Brigchen/iAquaria/iAqua/test/微信图片_20260914183111_5_65.jpg

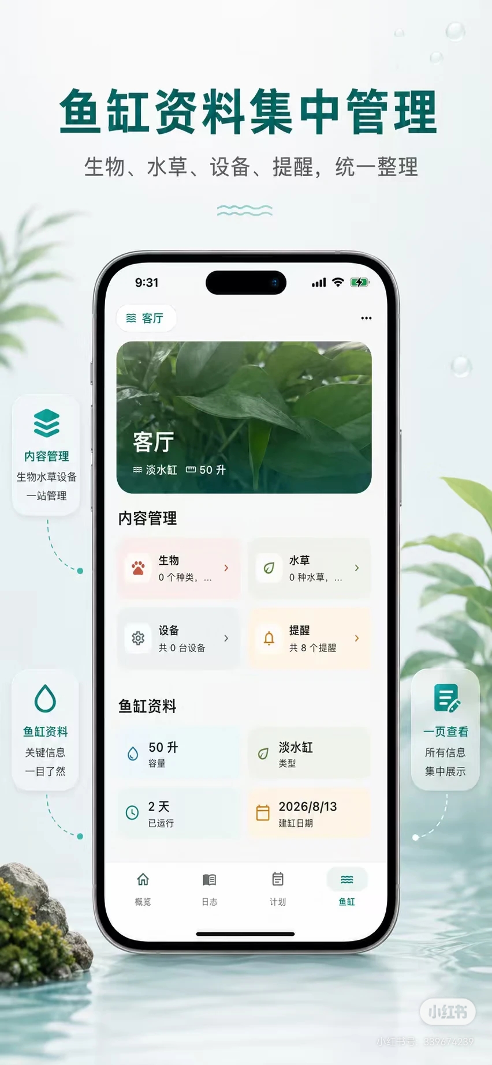
iAqua/test/微信图片_20260914183111_5_65.jpg
