Brigchen/iAquaria/iAqua/test/微信图片_20260914183106_3_65.jpg

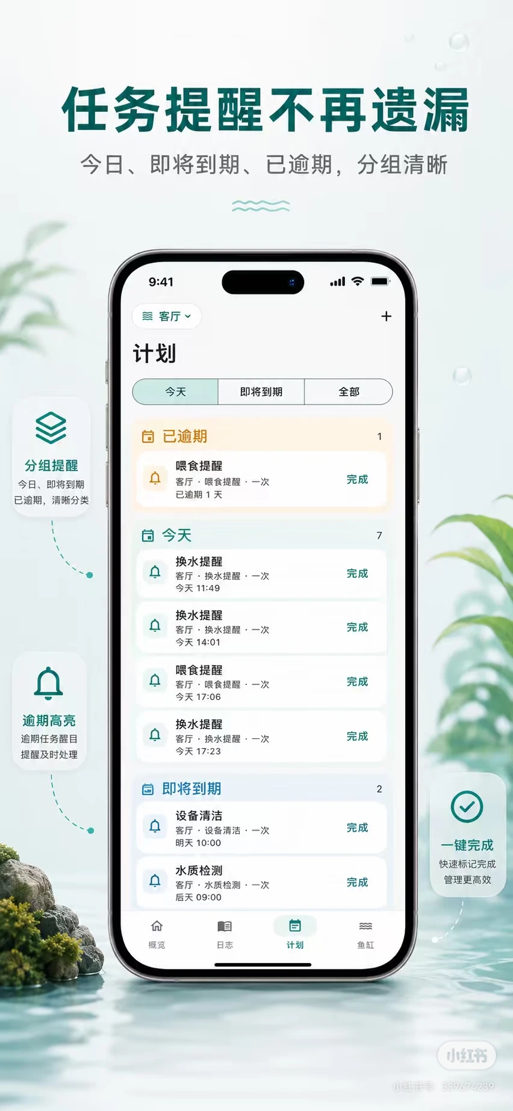
iAqua/test/微信图片_20260914183106_3_65.jpg
