Brigchen/iAquaria/docs/cam_hanger/README.md

# 鱼缸外挂摄像头吊架

A 板三颗 **Ø8.1** 孔（最上顶玻璃，下面两孔锁 B）；B 板长槽调长度。垫板中心同样 Ø8.1。两块均为封闭可打印实体。螺丝缩短，不进入玻璃。

重建：`build_cam_hanger.py`（需场景中已有 `Wall-mount`、`ball standard`、`Finger Screw`）。打印件：`CamHanger_Upper.stl`、`CamHanger_Lower.stl`。
