Brigchen/iAquaria/docs/gy30_case/README.md

# GY-30 光照外壳

PCB **32.6×15.1 mm**，焊针后总高 **11.2 mm**。BH1750 中心距顶边 **12 mm**。感光面朝上。

上壳套在下壳外面。左右长边有互配波浪纹卡住。上盖顶厚 0.75 mm。底板两端是以固定孔为圆心的半圆。走线在**短边**，用上下开口槽而不是封闭圆孔：先装板、放线，上盖仍能套下去。下壳左右内壁各 1 mm 托板、高 8 mm。STL：`GY30_Base.stl`、`GY30_Lid.stl`。
