Brigchen/iAquaria/docs/sr04_bracket/README.md

# HC-SR04 缸沿支架

**倒 L + H 夹**：上横板（**34**×80，四角倒圆 Ø10，2×M3，孔心距内竖板 15 mm）托 **12 mm** 厚超声波，传感器在**横板下面**。H 内外竖板与横档均为 **5 mm 厚、50 mm 宽**；内竖板一通到横板底，顶部开 **23×12 mm** 过线口。外侧 **2×M8×1.25 内螺纹**（大径 8.5）顶紧（≤10 mm 玻璃）。

尺寸见 [dimensions.md](dimensions.md)。重建：`build_sr04_bracket.py`。打印件：`stl/SR04_Bracket.stl`。
