Brigchen/iAquaria/docs/tds_h_bracket/README.md

# 单 TDS 缸沿支架

用于单独测 TDS：H 夹骑缸沿，上横板高出 20 mm，缸内竖板下伸 **140 mm**，上下各一个 **Ø10** 孔。外竖板 **1×M8×1.25 内螺纹**（大径 8.5）顶紧，横板 **21.8×18 mm**。总高 **170 mm**。游离直角倒成直径 **10 mm** 弧角，两板连接处保持直角。

尺寸见 [dimensions.md](dimensions.md)。重建：`build_tds_h_bracket.py`。打印件：`stl/TdsH_Bracket.stl`。
