Brigchen/iAquaria/docs/cam_hanger/dimensions.md

# 鱼缸外挂摄像头吊架

A = 靠玻璃的外竖板（与挂钩一体），**三颗 M8×1.25 内螺纹**。B = 外侧竖板，长槽调长度。

| 项 | mm |
|---|---|
| 板厚 | **5** |
| 竖板宽 | **18** |
| A / B 各长 | **100** |
| 凹字 | A 板外侧（顶孔与下孔之间）**iAquaria-JMU**，长 **34**，深 **1** |
| 玻璃槽 | **12**（≤10 mm 玻璃） |
| A 最上孔 | **Ø8.1**，顶玻璃 |
| A 下面两孔 | **Ø8.1**，与 B 槽锁相对位置 |
| B | 槽宽 **9.0**、长 80（通孔槽，螺丝穿过再旋入 A） |
| 接头垫 | 30×30×5，中心 **Ø8.1**，游离角倒圆 |
| 倒角 | 竖板游离端沿板面 **Ø10**；垫板游离角 **Ø10**。上横板与竖板相连处不倒。 |
| A/B 螺丝 | M8×1.25，牙长 **10**（头在 B 外侧，不进入玻璃槽） |
| 顶玻璃螺丝 | M8×1.25，牙长 **8** |

打印件：`CamHanger_Upper.stl`（A）、`CamHanger_Lower.stl`（B）、`M8x1.25x20.stl`。

四孔（A 竖向三孔 + 垫板中心）均为封闭实体上的 **Ø8.1** 孔（比 M8 大径 8.0 略大，PETG 自攻能咬住）。B 槽仍为 Ø9 以便穿过。A/B 各为一块封闭网格。
