Brigchen/iAquaria/docs/probe_h_bracket/dimensions.md

# 温度 / TDS / pH 缸沿支架（倒 L + 整体 H 夹）

坐标系：玻璃演示 X=0..8，**缸沿顶面 Z=0**；缸内 −X。上横板底面 Z=**20**（缸沿上 2 cm）；下横板顶面 Z=**−140**（缸内下伸 14 cm）。总高 **170 mm**（上顶到下底）。

横板伸入缸内按 **Ø30** 收到最窄；沿缸沿随孔径加宽，四孔：水温、TDS、pH、pH 补偿温度（贴 pH）。

H 夹：槽宽 12（≤10 mm 玻璃），外侧 **2×M8**。

## 上 / 下横板（同孔径）

| 项 | 尺寸 mm |
|---|---|
| 外廓 | **41.8 × 70.8 × 5**，游离端两角倒圆 **Ø10**（R5；靠竖板的角不倒） |
| 上横板 | 底面 Z=**20** |
| 下横板 | 顶面 Z=**−140** |
| 水温孔 | **Ø8.2**（名义 Ø8），Y = **−28.5** |
| TDS 孔 | **Ø10.2**（名义 Ø10），Y = **−16.5** |
| pH 孔 | **Ø30.2**（名义 Ø30），Y = **+6.5** |
| pH 补偿温度孔 | **Ø8.2**（名义 Ø8），Y = **+28.5**（pH 旁） |
| 孔心 X | **−23.9**（贴竖板，Ø30 + 2.8 壁） |

探头从上横板穿入，由下横板第二孔导向，保持竖直。

## 缸内竖板

| 项 | 尺寸 mm |
|---|---|
| 壁厚 | 6 |
| 宽度 Y | 70.8（与横板同宽） |
| 下伸 | 缸沿向下 **140**，连到下横板 |
| 总高 | **170**（上横板顶 Z=25 → 下横板底 Z=−145） |

## 竖向 H 夹

| 项 | 尺寸 mm |
|---|---|
| 槽宽 | **12**（≤10 mm 玻璃） |
| 外侧壁 | 厚 **6**（与内竖板相同）、宽 **70.8**、下垂 40 |
| 横档 | 厚 8，骑在缸沿 |
| 2×M8 | **M8×1.25 内螺纹**，大径 **8.5**（配 ISO M8 螺丝），Y=±20，Z=−20 |

打印件：`stl/ProbeH_Bracket.stl`。M8 与超声波支架共用。
