Brigchen/iAquaria/docs/seal_ring/dimensions.md

# 密封圈

两只共用：谷底直径 **72**、两边厚 **3**、谷底厚 **2**、顶面二次曲线、底面平整。

| 件 | 内径 | 外径 | 径向宽 | STL |
|---|---|---|---|---|
| A | **68.5** | **75.5** | 3.5 | `stl/SealRing.stl` |
| B | **68.75** | **75.25** | 3.25 | `stl/SealRing_68.75.stl` |

帽形密封件（内腔不变，帽壁向外 **1.6 mm**）：

| 项 | mm |
|---|---|
| 底面椭圆 | **22 × 11** |
| 帽体外 | 长轴 **13.2**，短轴 **8.2**（腔内 + 2×1.6） |
| 底孔 | **8 × 4**（不变） |
| 腔内 | **10 × 5**（不变） |
| 帽壁 | 长/短轴均为 **1.6** |
| 总高 | **5.4**（顶壁 1.6，腔内顶 z 不变） |
| 边沿厚 | **1** |

打印件：`stl/SealCap.stl`。
