Brigchen/iAquaria/docs/sensor_mounts/dimensions.md

# iAqua 传感器支架 — 严格尺寸（mm）

坐标：穿壁板 **X 右、Z 上**；**Y 穿玻璃**（缸外 Y+，缸内 Y−）。板中心为原点 (0,0,0)，板面在 XZ 平面。

## 1. Bulkhead_Outer / Bulkhead_Inner / DrillGuide

| 项 | 尺寸 |
|---|---|
| 板外廓 | 120 × 100 |
| 外板厚度 | 8.0 |
| 内板厚度 | 6.0 |
| 设计玻璃厚度 | 8.0（6–12 用 M4 垫圈 shims） |

### 1.1 四角 M4 穿板（对夹玻璃）

| 孔位 (X, Z) | 孔径 | 备注 |
|---|---|---|
| (−50, −40) | **Ø4.4** 通孔 | M4 螺栓 clearance |
| (+50, −40) | Ø4.4 | |
| (−50, +40) | Ø4.4 | |
| (+50, +40) | Ø4.4 | |

**外板缸外面**：同位置 **沉孔 Ø8.0 × 深 4.2**（M4 内六角圆柱头 ISO 4762）。

**内板缸内面**：同位置 **M4 六角螺母腔 7.8 对边 × 深 5.0**（通孔仍 Ø4.4）。

**玻璃上钻孔**：Ø4.2（M4 通孔），孔心同上表。

### 1.2 密封槽（外板贴玻璃面、内板贴玻璃面各一圈）

| 项 | 尺寸 |
|---|---|
| 槽中心线 | 距板边 5.0 |
| 槽宽 | 2.0 |
| 槽深 | 1.5 |
| 填料 | Ø2 硅胶条或硅酮胶 |

### 1.3 传感器 / 线缆孔（板与玻璃同轴）

| 名称 | 中心 (X, Z) | 板孔 Ø | **玻璃钻孔 Ø** | 连接件 |
|---|---|---|---|---|
| TEMP DS18B20 | (−30, +8) | 6.4 | **6.0** | `Gland_Body_6mm` + `Gland_Ring_6mm` + 采购 M10×1 锁母 |
| pH 电极 | (0, +8) | 12.5 | **12.0** | 电极自带 M12×1.5 锁母 + Ø12 O 圈 |
| TDS 电极 | (+30, +8) | 12.5 | **12.0** | 同上 |
| PG7 线缆 | (0, −28) | **12.5** | **12.5** | 采购 **PG7** 防水接头（锁板厚 2–8 mm） |

PG7 标准：建议孔 **12.5 mm**；锁紧螺母外径约 18 mm，外板此处无沉孔，靠 PG7 金属螺母压紧。

### 1.4 紧固件清单（单套穿壁板）

| 件 | 规格 | 数量 |
|---|---|---|
| 内六角螺栓 | M4 × 45 不锈钢 | 4 |
| 平垫 | M4 外径 9 | 4 |
| 螺母 | M4 不锈钢 | 4（或用内板 nut trap + 螺栓从外拧入） |
| 玻璃垫 shims | PETG 0.5 / 1 / 2 mm | 按需 |

---

## 2. Gland_6mm（DS18 探头）

| 项 | 尺寸 |
|---|---|
| 法兰外径 | 24.0 |
| 法兰厚 | 8.0 |
| 通孔（探头） | Ø6.4 H7 |
| 外螺纹区 | 模拟 M10×1：外径 10.0，有效长 12.0（实际用 M10 锁母压法兰） |
| `Gland_Ring_6mm` 内孔 | Ø6.0 → 锥面压紧 6 mm 探头 |

---

## 3. RimClip_Base + RimClip_Jaw

| 项 | 尺寸 |
|---|---|
| 夹口高度（可调） | 8.0–12.0（默认 10.5 开口 + 1.5 预压） |
| 夹持深度（扣入缸沿） | 14.0 |
| 轨槽 | 宽 20.0 × 深 6.0 × 长 14.0（`VerticalRail` 榫头） |
| 压紧螺钉 | **M5×50** 内六角 |
| 固定块孔 | Ø5.5 通孔 |
| 活动块 | M5 **六角螺母腔 9.0 对边 × 深 5.0**（缸外可及） |

---

## 4. VerticalRail

| 项 | 尺寸 |
|---|---|
| 外廓 | 20 × 128 × 6 |
| 底部榫头 | 20 × 12 × 6（插入 RimClip 槽） |
| 轨向 M3 安装孔 | Ø2.9 通孔，Z 中心距底 **18, 38, 58, 78, 98, 118** |
| 螺钉沉孔（贴缸壁面） | Ø6.5 × 深 3.2（M3 内六角 ISO 4762） |
| 侧向锁紧 | M4 螺纹孔 **3.2 底孔** + 打印 **M4 热熔铜螺母**，位置 (X=+8, Z=6) |

---

## 5. Mount_SR04（HC-SR04）

| 项 | 尺寸 |
|---|---|
| PCB 包容 | 45.0 × 20.0 × 15.0（Transducer 朝下） |
| 侧夹持 | 内宽 20.2，深 12.0 |
| 安装耳 | 2× Ø2.9，孔距 **20.0**（Z 向），距背板中心线 ±10 |
| 固定螺钉 | M3×10 内六角 × 2 |

---

## 6. Mount_BH1750（GY-30）

| 项 | 尺寸 |
|---|---|
| PCB 包容 | 16.5 × 16.5 × 5.0 |
| 腔体 | 22 × 22 × 12（顶开，线从背板 PG7 或走线孔 Ø4.0） |
| 倾角 | 15°（受光面朝灯带） |
| 安装 | 2× Ø2.9，孔距 20.0，M3×8 |

---

## 7. 装配顺序（穿壁）

1. `DrillGuide` 贴玻璃标记 → 钻 4×Ø4.2 + 1×Ø6 + 2×Ø12 + 1×Ø12.5。  
2. 玻璃两面清洁，贴密封槽硅胶。  
3. 内板（湿）→ 玻璃 → 外板（干），M4×45 对角拧紧 **2 N·m** 量级，勿爆玻璃。  
4. 探头 / PG7 从缸内穿出，锁母 + O 圈。  
5. DS18 先穿 `Gland_Ring` + 法兰，再锁 M10 螺母。
