Brigchen/iAquaria/docs/演示文稿1.pptx

6mm

12mm

22mm

11mm

1mm

7mm

12mm

22mm

10mm

5mm

缸外

缸内

上横

调节壁厚固定螺丝

A竖板

夹玻璃

固定AB竖板螺丝

B竖板

万向接头

下面接摄像头

## Slide 2

阿卡
（在相机顶面，上宽下窄，才可以卡坐快接母口）

镜头
（前视角）

USB-type-c 母座模块
（在相机底面）
