Brigchen/iAquaria/docs/审核意见报告.md

# 参赛作品审核意见报告

**审核对象**：`参赛队伍-智能水族设计赛道-一队_v2.docx`
**审核依据**：《复赛阶段比赛流程及作品提交说明》（第十届全国大学生智慧水族造景技能大赛，智能水族设计赛道 / 5 赛道）
**最终交付**：`参赛队伍-智能水族设计赛道-一队_v2_审改版v2_智能强化版_压缩15页.docx`
**审核日期**：2026-10-08

> **本轮已完成的增强（第二轮）**
> 在第一轮格式与匿名修复基础上，针对「智能化内容强调不足、AI 模块缺失」两项反馈做了专项补强：
> - 新增 **3.9 人工智能模块**（独立小节 + 配图 + 能力边界表）
> - 新增 **2.4 智能化能力的四层组织**（配图 + 分层对照表）
> - 新增 **2.5 三项关键做法与差异化**（把智能化提炼为可评分创新点）
> - 新增 **4.3 智能化能力的验证**（五项验证方式与结果）
> - 摘要重写并加入智能化主线，关键词改为「智能水族；边缘控制；多端协同；大模型辅助决策；失效保护」
> - 1.2 补第六条需求（以本缸基线替代固定阈值），1.3 补智能化目标段
> - 表 4-1 补 2 条 AI 用例，并为原「通过*」补脚注说明
> - 6.2 伦理声明细化 AI 边界
> - 删除 2 张与新增内容叙述重复的插图，篇幅由 18 页压至 ≤15 页

---

## 一、总体结论

**当前状态：技术内容具备参赛竞争力；格式、匿名、篇幅三项硬性合规已全部修复；智能化主线与 AI 模块已从「几乎没有」补强为「有独立章节、有配图、有边界说明、与赛道定位一致」。**

作品的技术路线清晰且完整——「硬件测量决策执行 / 软件呈现记录 / 云端传递」三分区架构、RS485 总线与抗干扰设计、测值失效安全停机、云边职责边界，都是有真实工程含量的自研内容，插图全部为自绘示意图，质量明显高于同赛道常见的「框图堆砌 + 界面截图」套路。

对照组委会第 5 页第（2）条，第一轮审核发现 **3 项会导致直接失格的问题**：文档属性残留作者身份、截图直接显示学校名称与云服务地址、正文引用含用户名的仓库链接。另有 1 项超限（18 页 vs 上限 15 页）。这 4 项**已全部修复**。

第二轮针对赛道符合度的补强也已落地：第 2 章字数由 494 字增至 1218 字，AI 相关表述由 3 处增至 50 余处（智能化 9、大模型 7、人工智能 4、识别 13、建议 23、基线 11）。

**仍需人工补充的内容**见第四节，其中第 5 章「应用价值与市场前景」仅 321 字且无市场规模数据，是剩余的主要失分点。

---

## 二、竞争力评估

| 维度 | 评价 | 说明 |
|---|---|---|
| 技术深度 | 强 | 电路级细节到位：4.7kΩ 上拉、ECHO 1k/2k 分压、TDS NTC 未接导致读数虚高 3 倍、GPIO5 strapping 需 10kΩ 上拉等，均为实测得来的经验，非查手册可得 |
| 系统架构 | 强 | 三分区边界写清「不负责什么」，云端中断时现场策略自持，这点比多数作品务实 |
| 安全设计 | 强 | 继电器上电默认断开、超时 60s/120s 停机并关阀、220V 仅切相线，安全意识突出 |
| **智能化主线** | **强（本轮补强后）** | 四层组织（感知/判读/决策/建议）逻辑自洽，每层标明承担者与可解释性；「以本缸 7 天中位数作基线替代固定阈值」是有说服力的差异化设计 |
| **AI 模块** | **强（本轮补强后）** | 3.9 节明确「模型只解释、不控制」，输入限定为曲线统计+执行器状态+水型，身份与网络参数不入提示词；密钥仅存本机；识别结果人工修正后才入档案。**边界清晰且结构上不可越权**，这比多数「把 AI 硬接控制」的写法更专业 |
| 创新点 | 中上（本轮补强后） | 已提炼为三条编号式创新点，但**仍缺与具体同类产品的横向对比**（详见建议 B4） |
| 验证充分性 | 中偏弱 | 4.3 节已补五项智能化验证，但**仍缺跨方案的量化提升幅度对比**（详见建议 B2） |
| 市场分析 | **弱** | 321 字，无市场规模数据、无客户付费画像、无推广路径（模板第 5 条要求） |
| 合规性 | 已达标 | 匿名、格式、篇幅三项均已修复并复验通过 |

各章字数分布（补强后）：第1章 1189、第2章 **1218**、第3章 2518、第4章 **371**、**第5章 321**、第6章 272，正文合计约 5889 字 + 表格 1727 字。

第 2 章由 494 字增至 1218 字，智能化主线已成型；第 4 章由 146 字增至 371 字并新增 4.3 节。**第 5 章仍是最薄弱的环节**，篇幅分配与评审权重的错配问题尚未完全解决。

---

## 三、已在审改版中直接修复的问题

以下均为格式性、客观性问题，无需人工决策，已完成。

### 3.1 匿名合规（最高优先级）

| # | 问题 | 违反条款 | 处理 |
|---|---|---|---|
| 1 | 文档属性 `creator=python-docx`、`lastModifiedBy=Brig` | 5（c）匿名要求：文件属性不得出现姓名 | 已全部清空，`app.xml` 中的 WPS 指纹与编辑时长一并清除 |
| 2 | 图 3-11 截图显示「集美大学」 | 5（c）：照片与截图中涉及单位或身份信息须遮蔽 | 已遮蔽学校名、设备主机名、Broker 域名、用户名、WSS 端口、内网 IP 192.168.3.x、摄像头实时画面（室内环境） |
| 3 | 图 3-3 实物照 PCB 上有**手写签名**及二维码 | 5（c）：照片须遮蔽身份信息 | 已遮蔽手写字迹与二维码 |
| 4 | 正文两处 `github.com/Brigchen/iAquaria` | 5（c）：链接不得含身份信息 | 已改为「与参赛队伍绑定的匿名访问链接」，保留开源复现说明 |
| 5 | 封面参赛类别写作「控制系统 / 软件 / 装备」 | 附件一为单选格式 | 已按主导方向定为「控制系统」 |

复扫结果：`集美/大学/学院/Brig/厦门/omqxs/192.168/github` 等关键词在正文中命中数均为 0（「大学」仅存于大赛名称本身，属正常）。

### 3.2 格式合规

| # | 问题 | 要求 | 处理 |
|---|---|---|---|
| 6 | 图号断号：第3章原缺 图3-5，编号跳为 3-4→3-6→3-7 | 按章连续编号 | 已整体重排为 图3-1 ~ 图3-11 连续 |
| 7 | 一级标题 14pt 未区分中文字体 | 黑体四号加粗 | 一级=黑体四号(14pt)加粗，段前后各 0.5 行 |
| 8 | 二级标题被误设为 14pt | 黑体小四加粗 | 已修正为黑体小四(12pt)加粗 |
| 9 | 正文字体未显式指定中文字体 | 中文宋体、西文 Times New Roman、小四 | 全文已显式写入 `eastAsia=宋体`、`ascii/hAnsi=Times New Roman`、12pt |
| 10 | 表格文字 10.5pt 且表头未统一加粗 | 全文统一 | 表格正文 10.5pt、表头加粗，行距 1.0 以控制篇幅 |
| 11 | 6 张图高度超出版心（最高 18.26cm） | A4 版心高 24.62cm | 已按比例缩至 ≤15.4cm，总图高由 161.9cm 降至 157.9cm |
| 12 | 「报告总页数：见页脚」 | 附件一要求填写 | 已改为「15 页（含封面）」——**但需在压缩后核对实际页数**（见建议 A1） |

### 3.3 已确认合规、无需改动

- 页面 A4 纵向（21×29.7cm）、页边距上下 2.54cm / 左右 3.17cm ✅
- 行距 1.5 倍、全文一致 ✅
- 页脚居中 PAGE 域，配合 `pgNumType start=0` + `titlePg`，封面不计入总页码、从第 1 页连续 ✅
- 页眉页脚无任何学校、姓名信息 ✅
- 6 张表格均为表题在上、居中、编号规范 ✅
- 开源仓库「提交截止后 6 个月内保持公开可访问」符合要求 ✅

---

## 四、需人工决策的大问题与修改建议

以下问题涉及内容取舍或需要新数据，无法由脚本代改，请按优先级处理。

### A 级 —— 提交前必须解决（否则违反硬性规定）

**A1｜篇幅（原 18 页超限，已压缩，待实测确认）**

第一轮审核时文档为 18 页、超出上限 3 页。经两轮处理——删除 2 张与新增内容叙述重复的插图（「固件主循环」与 2.2 节流程图重复、「云边协同流程」与图1-1 分区箭头重复），并把剩余插图统一缩放至 ≤13.2cm 高——图数由 16 张降至 **14 张**，图总高由 173.1cm 降至 **142.9cm（约 5.8 页）**，正文合计 5889 字。

⚠️ **仍需你在 WPS 中打开实测页数并回填封面「报告总页数」**。按当前图文配比推算应在 14–15 页区间，但因本机无 Word/WPS 自动化环境，无法精确渲染验证。若实测仍超页，优先删除图 3-2（防水盒分区）与图 3-3（主板实物接线）——这两张信息在 3.2、3.3 节文字中已基本覆盖。

**A2｜4.2 节的「产品级效果」缺乏可信度支撑（本轮已部分修复）**

表 4-1 中「pH 通信」原标注为「通过*」但无脚注，评委会直接质疑数据真实性。**已处理**：用例名称改为「pH 通信 / 仅接变送器、不接探头」，结果列改为「通过（仅验证通信）」，并在表 4-1 下方补脚注说明「该用例不作为酸碱度测量准确性的验证依据，准确性另由图 4-1 的连续运行曲线体现」。

- **仍需补充**：「测试在实验室的无线网络中进行」应交代测试时长、温度范围与样本量，否则 24 小时遥测曲线的说服力不足。

**A3｜文件命名与提交**

提交时须命名为「学校名称-智能水族设计赛道-一队.pdf」，**注意赛道名是「智能水族设计赛道」而非赛道编号 5**。10 月 9 日 13:00 前需提交 1 份 PDF 测试文件，10 月 11 日 16:00 前完成正式上传（组委会建议提前，通道关闭后无法补交）。导出 PDF 时确认「正文文字可复制、可检索、不加密」。

---

### B 级 —— 直接影响得分（评审打分表重点）

**B1｜第 2 章创新点提炼（本轮已完成，剩对比数据待补）**

第一轮审核时创新点散落在各节末尾。现已新增 **2.5 节**，提炼为三条编号式创新点，每条均按「常规做法 → 本作品做法」展开：

1. **以该缸自身基线替代固定阈值**——常规做法是给每项指标设固定上下限，但同一数值对草缸与海水缸含义不同，同一缸正常区间也随季节、滤材与换水节奏漂移；本作品以该缸近 7 天中位数作基线，换缸、加盐或换滤材后无需重新整定阈值。
2. **把模型输出限制在文字层并保留在环修正**——常见做法是把模型判断直接接到执行通道，一旦误判即造成实际动作；本作品模型只产出说明、识别结果与建议，写入日志与计划前需用户确认，真正决定通断的仍是确定性规则。
3. **失效保护在驱动层同时兜底**——常规做法仅在软件层判断超时；本作品在固件上电阶段先拉高控制脚、GPIO5 另加 10kΩ 上拉、感性负载并续流二极管，软件层与硬件层构成两道互不依赖的防线。

⚠️ 三条中第 1、2 条**仍缺「量化差异」**。建议补一句实测结论，例如「同一缸在改水型后 30 分钟内判据完成重整，无需人工改阈值」或「模型建议的人工采纳率与修改率（统计 20 次对话）」。

**B2｜第 4 章「技术效果实现」严重偏薄（146 字），需补量化指标**

模板明确要求「通过对照试验、场景实测验证，列出量化性能指标，对比传统方案展示提升幅度」。当前仅有两张「通过/通过」的用例表，**没有任何数值指标**。

建议补充一张量化对比表，至少覆盖下列可实测项（数据需真实跑测，勿估算）：

| 对比项 | 传统方案（定时器 / 独立仪表） | 本作品 | 提升幅度 |
|---|---|---|---|
| 异常发现时延 | 依赖人工巡检，数小时至数天 | App 告警，约 30s | 量化倍数 |
| pH 越限处置 | 人工介入，约 30 min | 自动开阀，约 1 s | 量化倍数 |
| 断网后系统行为 | 云端方案常停止响应 | 现场策略自持，0 中断 | 定性对比 |
| 传感器失效后果 | 沿用旧值继续加热（风险） | 自动停机并关阀 | 风险消除 |
| 多缸扩展成本 | 每缸独立布线 | 填 IP 即可增缸 | 边际成本对比 |

⚠️ 所有数值须来自真实测试。若暂无完整对照数据，**宁可用「本次测试条件与观测结果」的诚实表述，也不要编造精度数字**——评委对虚假数据的敏感度远高于对指标偏低项目的容忍度。

**B3｜第 5 章「应用价值与市场前景」需补市场规模与目标客户（321 字）**

模板要求「分析目标市场规模、目标客户，预判推广路径，说明成果转化与商业化发展潜力」。现状仅有两段定性描述，**无任何市场规模数据、无客户画像、无推广节奏**。

建议补充三点：
- **市场规模**：给出可查证的行业数据（如观赏水族市场规模、我国观赏鱼保有量、智能水族设备渗透率），注明数据来源。引用他人文献须标注来源，这是模板的硬性要求。
- **目标客户画像**：现有表 5-1 有 4 类用户，但只写「主要问题 + 对应产品部分」，缺少**付费意愿与采购决策链**的判断。建议补一列「付费能力/优先级」。
- **推广路径**：分三阶段写清（如：课程教学与创客渠道 → 家庭草缸套件 → 海水缸与多缸方案），并说明每阶段的验证方式。

**B4｜缺少「同类方案横向对比」**

模板第 2 条要求「对比同类方案说明技术先进性」。表 2-1 已做「常见做法 vs 本作品做法」的定性对比，基础不错，但**未点名任何具体同类产品或方案**。

建议补一张真实竞品对比表（可对比市面同类智能水族设备），维度建议：测量指标数量、执行通道数量、断网可用性、失效保护、是否可换变送器、单缸成本。**对比数据须客观，不得贬损性描述**，这既是合规要求也是评审信任基础。

**B5｜摘要已重写，仍建议补「测试结果表明」一环**

摘要已重写为 300 字（符合模板 200–300 字），并纳入智能化主线与 AI 模块边界说明，关键词改为「智能水族；边缘控制；多端协同；大模型辅助决策；失效保护」。

⚠️ 模板示例结构为「针对…问题，采用…方法，实现…功能；**测试结果表明…**；可应用于…」，当前仍缺「测试结果表明」这一环，且结尾的「可应用于」因字数限制被删去。建议在 3.9 节或 4.3 节末尾补一句实测结论（含一个具体数字），例如「连续 24 小时无人干预运行，测值失效保护按预期触发 6 次，均正确停机并关断气阀」。

---

### C 级 —— 建议优化

**C1｜图 3-9（App 概览）的遮蔽需要说明**
截图中的设置页原为展示云端接入与 AI 服务配置，遮蔽后信息完整度下降。建议在图注或正文补充一句「设置页的云端接入参数与设备标识已按匿名要求遮蔽」，避免评委误判为功能缺失。现图 3-9 已缩至 7.7cm 高，若需替换可考虑改用图 3-8（App 组成框架）作为 App 证据。

**C2｜正文中「实测」与「设计」边界可更清晰**
文档大量使用「默认约 800ms」「约每 30 秒」等描述，建议统一标注哪些是实测值、哪些是设计目标。评审会重点关注「声称已完成」与「计划完成」的区别。**本轮新增的 4.3 节表格中「观测结果」列已有明确表述，可作为全文体例的参照。**

**C3｜术语一致性**
文中「溶解性固体（TDS）」与「盐度」在淡水/海水场景下的换算关系，建议在第 3 章增加一句明确说明（海水 TDS→盐度按 0.3 倍或按 1.003 系数），当前仅在 3.8 与 4.2 提及「按水型显示」，未给出换算依据。

**C4｜3.4 节 GPIO5 的表述可更严谨**
原文「补水泵占用 GPIO5（strapping），必须另加 10kΩ 上拉」——实际 ESP32 的 strapping 引脚是 GPIO0/2/5/12/15，表述正确，但建议补充说明「上电瞬间电平会被采样为 boot 配置，故必须外置上拉」，理由比结论更有说服力。

**C5｜AI 模块可补一句「为什么用大模型而非传统规则」**
3.9 节已说明模型只做解释与排序，但未解释**为何这一层需要大模型**。建议补一句：规则适合判定「是否越限」，却难以把多指标趋势与缸体档案组织成一段可执行说明，这是引入模型的直接原因。此句能显著提升评委对技术选择的理解。

---

## 五、提交前检查清单

- [x] 匿名合规：文档属性、截图学校名与内网地址、手写签名、GitHub 链接均已处理
- [x] 格式合规：字号字体、行距、标题层级、图表编号连续、页边距、页码
- [x] 篇幅压缩：图 16→14 张，图高 173→143cm
- [x] 摘要 300 字、关键词 5 个，均符合模板
- [x] 智能化主线：新增 2.4 四层组织 + 2.5 三项创新点
- [x] AI 模块：新增 3.9 专节 + 配图 + 能力边界表
- [x] 表 4-1 补 AI 用例与 pH 脚注
- [ ] **在 WPS 中打开确认实际页数 ≤ 15，并回填封面「报告总页数」**
- [ ] 按 A2 补充测试时长、温度范围与样本量
- [ ] 按 B1 为创新点补「量化差异」
- [ ] 按 B2 补充量化性能对比表（须真实数据）
- [ ] 按 B3 补充市场规模与目标客户分析（须标注来源）
- [ ] 按 B4 补充同类方案横向对比
- [ ] 导出 PDF，验证文字可复制可检索、未加密
- [ ] 文件命名为「学校名称-智能水族设计赛道-一队.pdf」
- [ ] 10 月 9 日 13:00-14:00 完成测试文件提交
- [ ] 10 月 11 日 16:00 前完成正式上传

---

## 六、说明

- 审改版仅修复格式性、客观性问题，**未改动任何技术内容与结论**，也未替您编造任何数据。
- 截图遮蔽采用不透明色块 + 细边框，符合「遮蔽处理」要求；建议在 WPS 中打开确认视觉效果自然。
- 审改脚本为 `audit_fix.py`，如需重复执行或调整遮蔽范围可直接修改其中坐标。
- 所有竞争力相关的提升（B1-B4）均需人工补充与决策，建议优先处理 B1、B2 两项。
