Brigchen/iAquaria/docs/report_assets/fig_roadmap.png

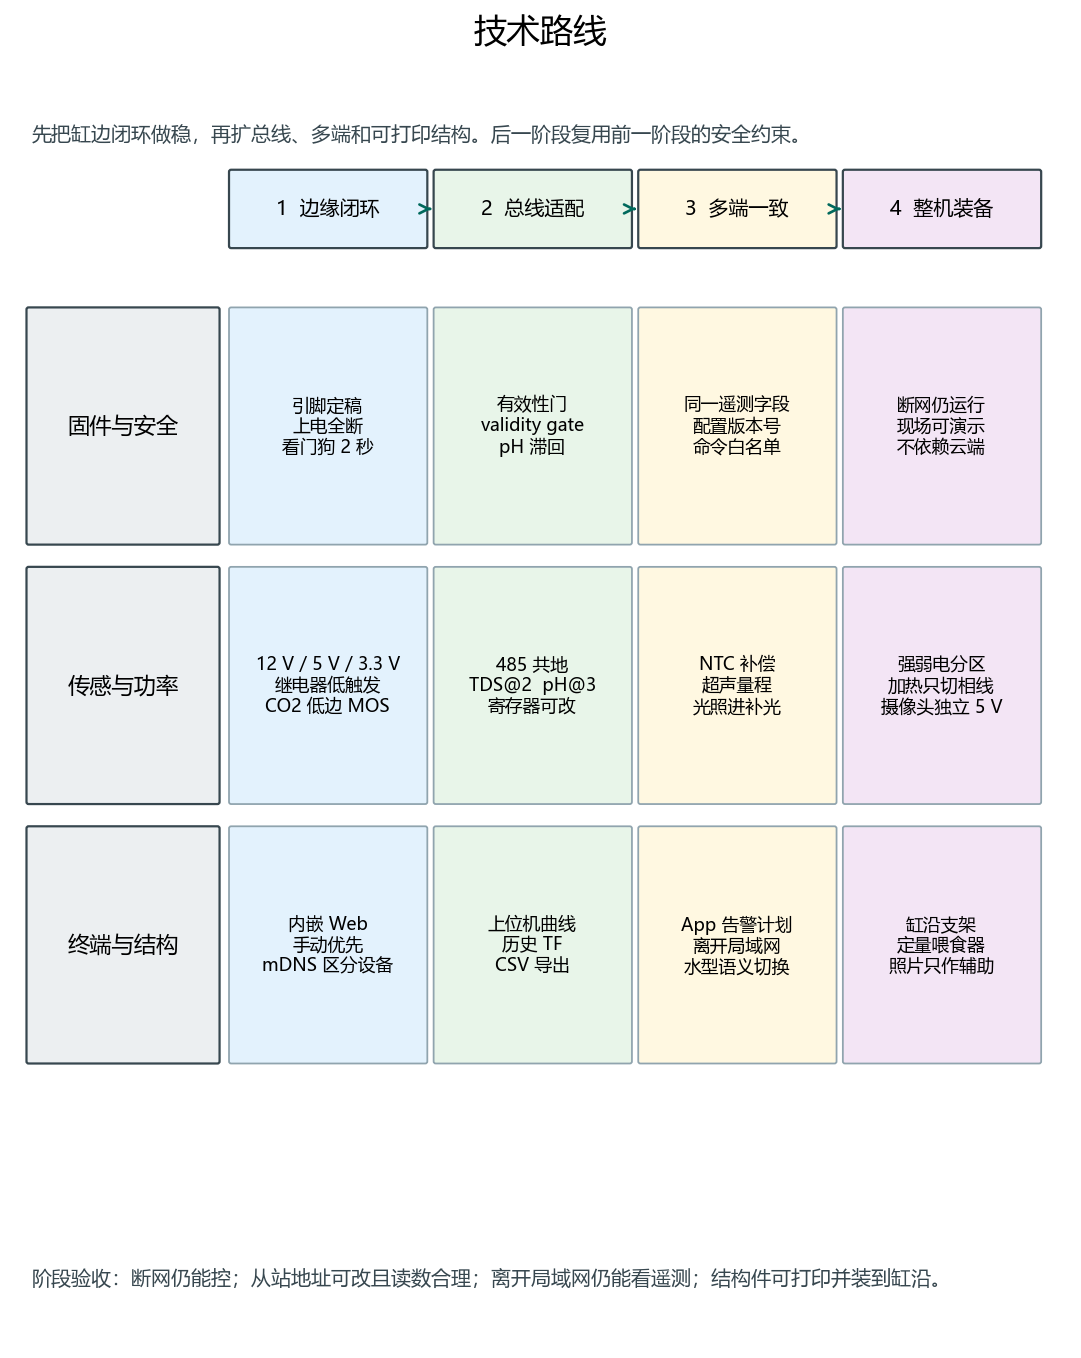
docs/report_assets/fig_roadmap.png
