Brigchen/iAquaria/docs/report_assets/hw_p3b.png

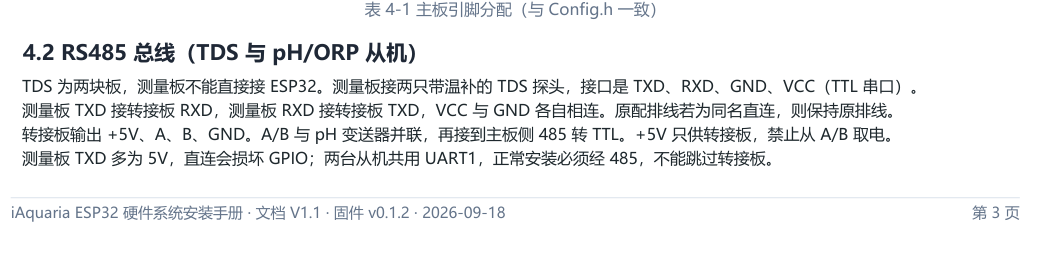
docs/report_assets/hw_p3b.png
