Brigchen/iAquaria/iAquaria/docs/screens/06_设置.jpeg

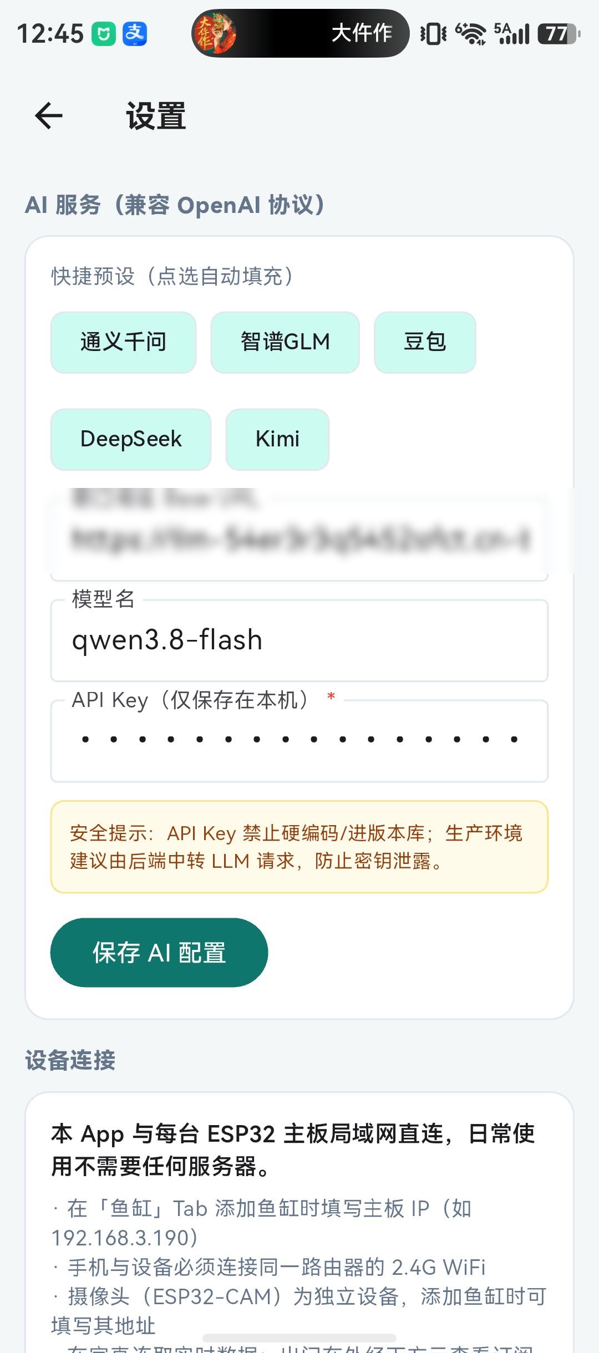
iAquaria/docs/screens/06_设置.jpeg
