Brigchen/iAquaria/docs/iAquaria-最小系统BOM.xlsx

Sheet: 最小系统BOM
序号 | 区分 | 类别 | 物料名称 | 规格型号 | 单套用量 | 十套用量 | 单位 | 单价（元） | 十套参考金额 | 来源 | 购买链接 | 用途 | 备注
1 | 必要 | 主控 | ESP32 开发板 | ESP32-DevKitC V4（ESP32-WROOM-32E） | 1 | 10 | 块 | 68 | 680 | 设备清单（2）.xlsx |  | 采集水温、TDS 与 pH | 采购 2 套；该行运费 15 元
2 | 必要 | 传感 | 水温探头 | DS18B20 防水型，不锈钢探头，约 1 m 线 | 1 | 10 | 只 | 6 | 60 | 设备清单（2）.xlsx |  | 测量水温 | DATA 须经 4.7 kΩ 上拉至 3.3 V
3 | 必要 | 传感 | TDS 传感器 | DFRobot SEN0244 模拟 TDS 传感器 | 1 | 10 | 套 | 96 | 960 | 设备清单（2）.xlsx |  | 测量溶解性固体 | 采购 2 套；该行运费 5 元。现行固件主路径为 RS485 变送器，模拟模块可直接完成最小测量
4 | 必要 | 传感 | pH 传感器 | DFRobot SEN0161 模拟 pH 计 V2，含配套探头 | 1 | 10 | 套 | 177.5 | 1775 | 设备清单（2）.xlsx |  | 测量酸碱度 | 采购 2 套。与 ORP 电极不同时接入
5 | 必要 | 无源器件 | 上拉电阻 | 1/6 W 金属膜 4.7 kΩ 1%，100 只装 | 1 | 10 | 只 | 2.47 | 2.47 | 淘宝订单 3316417466042003789 | https://item.taobao.com/item.htm?id=609077395130 | DS18B20 上拉 | 单价为 100 只包装价。10 套只用 10 只，金额按 1 包计
6 | 必要 | 连接 | BG12 防水接头 | 4 芯公母套装（公插座 + 母插头） | 3 | 30 | 套 | 1.48 | 44.4 | 淘宝订单 3316403751043003789 | https://item.taobao.com/item.htm?id=672248125634 | 水温、TDS、pH 各 1 套出盒 | 店名写作 GX12。已购 10 套，订单实付 64.51 元含同单其余规格。开孔 Ø12
7 | 必要 | 电源 | 12 V 电源适配器 | 12 V / 5 A，双线一体，60 W | 1 | 10 | 只 | 18.9 | 189 | 淘宝订单 3316403103025003789 | https://item.taobao.com/item.htm?id=535735315041 | 整机入口，可带后续 12 V 负载 | 已购 2 只。交易关闭的 1 只未计入
8 | 必要 | 电源 | 降压模块 | LM2596S 可调，带显示，3 A | 1 | 10 | 块 | 6.8 | 68 | 淘宝订单 3316864981002003789 | https://item.taobao.com/item.htm?id=844208531046 | 12 V 转为 5 V，供主控与模拟传感器 | 空载先调至 5.0 V。已购 3 块
9 | 必要 | 连接 | BG16 防水插座 | 2 芯公插座，焊 20 cm 线 | 1 | 10 | 只 | 4.23 | 42.3 | 淘宝订单 3316403751043003789 | https://item.taobao.com/item.htm?id=672248125634 | 12 V 进盒，装在盒壁 | 店名写作 GX16。已购 2 只。开孔 Ø16
10 | 必要 | 连接 | BG16 防水插头 | 2 芯母插头，焊 1 m 线 | 1 | 10 | 条 | 7.31 | 73.1 | 淘宝订单 3316431687011003789 | https://item.taobao.com/item.htm?id=672248125634 | 12 V 适配器侧对插 | 店名写作 GX16。已购 2 条，实付 14.61 元
11 | 必要 | 连接 | 电源开关 | 圆形面板开关，12 V，触点 ≥5 A | 1 | 10 | 只 |  |  |  |  | 开关机，串在 BG16 之后的正极 | 购物记录未含，不估价格。装在电源口旁，开孔 Ø12
12 | 必要 | 指示 | 开机指示灯 | 绿色面板灯，12 V，自带电阻 | 1 | 10 | 只 |  |  |  |  | 开关接通后点亮 | 购物记录未含，不估价格。装在电源口旁
13 | 必要 | 指示 | 故障指示灯 | 红色面板灯，12 V，自带电阻 | 1 | 10 | 只 |  |  |  |  | 测值无效或供电异常时点亮 | 购物记录未含，不估价格。装在电源口旁，由主控经三极管驱动
14 | 必要 | 结构 | 防水盒 | 防水盒 | 1 | 10 | 只 | 7.02 | 70.2 | 设备清单（2）.xlsx |  | 主控安装
15 | 必要 | 3D打印 | 探头缸沿支架 | ProbeH_Bracket，水温 Ø8、TDS Ø10、pH Ø30 | 1 | 10 | 只 |  |  | docs/probe_h_bracket/stl/ProbeH_Bracket.stl | 3d打印件 | 三只探头安装 | 自制，无采购价。顶紧为打印 M8 螺纹，购物记录未单列金属螺丝

Sheet: 说明
项目 | 说明
范围 | 本文件按 10 套计算水温、TDS 和 pH 最小系统。外部统一用 12 V/5 A，经二芯 BG16 进入防水盒。水温、TDS、pH 与外壳之间各用一套四芯 BG12。
电源口 | BG16 二芯公插座装在盒壁，母插头接适配器。旁边为电源开关、绿色开机灯和红色故障灯。开关串在正极。绿灯接在开关之后。红灯由主控经 S8050 点亮，基极串 1 kΩ。
盒内 | LM2596 将 12 V 降至 5.0 V，供 ESP32 与模拟 pH、TDS 模块。DS18B20 仍由主控 3.3 V 供电，DATA 经 4.7 kΩ 上拉。
数量 | 十套用量 = 单套用量 × 10。热缩管 10 套共用 1 卷。两只电阻的用量是安装只数，参考金额按 1 包包装价，不把包装价乘以只数。
价格 | BG12、BG16 单价来自曼宣家居淘宝订单，页面型号写作 GX12、GX16。开关、两只指示灯、三极管和探头支架没有采购价，金额留空。合计只加已有单价的行。
完整清单 | 光照、水位、摄像头、执行机构和安装工具见 iAquaria-样机物料清单.xlsx。
