Brigchen/iAquaria/docs/iAquaria-样机物料清单.xlsx

Sheet: 整机BOM
序号 | 区分 | 类别 | 物料名称 | 规格型号 | 单套用量 | 采购数量 | 单位 | 单价（元） | 来源 | 购买链接 | 用途 | 备注
1 | 必要 | 主控 | ESP32 开发板 | ESP32-DevKitC V4（ESP32-WROOM-32E） | 1 | 2 | 块 | 68 | 设备清单（2）.xlsx |  | 采集水温、TDS 与 pH | 采购 2 套；该行运费 15 元
2 | 必要 | 传感 | 水温探头 | DS18B20 防水型，不锈钢探头，约 1 m 线 | 1 | 2 | 只 | 6 | 设备清单（2）.xlsx |  | 测量水温 | DATA 须经 4.7 kΩ 上拉至 3.3 V
3 | 必要 | 传感 | TDS 传感器 | DFRobot SEN0244 模拟 TDS 传感器 | 1 | 2 | 套 | 96 | 设备清单（2）.xlsx |  | 测量溶解性固体 | 采购 2 套；该行运费 5 元。现行固件主路径为 RS485 变送器，模拟模块可直接完成最小测量
4 | 必要 | 传感 | pH 传感器 | DFRobot SEN0161 模拟 pH 计 V2，含配套探头 | 1 | 2 | 套 | 177.5 | 设备清单（2）.xlsx |  | 测量酸碱度 | 采购 2 套。与 ORP 电极不同时接入
5 | 必要 | 无源器件 | 上拉电阻 | 1/6 W 金属膜 4.7 kΩ 1%，100 只装 | 1 | 100 | 只 | 2.47 | 淘宝订单 3316417466042003789 | https://item.taobao.com/item.htm?id=609077395130 | DS18B20 上拉 | 单价为 100 只包装价。10 套只用 10 只，金额按 1 包计
6 | 必要 | 无源器件 | 限流电阻 | 1/6 W 金属膜 1 kΩ 1%，100 只装 | 1 | 100 | 只 | 2.57 | 淘宝订单 3316401879043003789 | https://item.taobao.com/item.htm?id=609077395130 | 故障灯基极限流 | 单价为 100 只包装价。10 套用 10 只，金额按 1 包计
7 | 必要 | 连接 | 杜邦线 | 10 cm | 1 | 1 | 套 | 8.76 | 设备清单（2）.xlsx |  | 盒内 BG12 插座到主控
8 | 必要 | 连接 | 杜邦线 | 21 cm | 1 | 1 | 套 | 9.87 | 设备清单（2）.xlsx |  | 盒内加长引线
9 | 必要 | 连接 | BG12 防水接头 | 4 芯公母套装（公插座 + 母插头） | 3 | 10 | 套 | 1.48 | 淘宝订单 3316403751043003789 | https://item.taobao.com/item.htm?id=672248125634 | 水温、TDS、pH 各 1 套出盒 | 店名写作 GX12。已购 10 套，订单实付 64.51 元含同单其余规格。开孔 Ø12
10 | 必要 | 电源 | 12 V 电源适配器 | 12 V / 5 A，双线一体，60 W | 1 | 2 | 只 | 18.9 | 淘宝订单 3316403103025003789 | https://item.taobao.com/item.htm?id=535735315041 | 整机入口，可带后续 12 V 负载 | 已购 2 只。交易关闭的 1 只未计入
11 | 必要 | 电源 | 降压模块 | LM2596S 可调，带显示，3 A | 1 | 3 | 块 | 6.8 | 淘宝订单 3316864981002003789 | https://item.taobao.com/item.htm?id=844208531046 | 12 V 转为 5 V，供主控与模拟传感器 | 空载先调至 5.0 V。已购 3 块
12 | 必要 | 连接 | BG16 防水插座 | 2 芯公插座，焊 20 cm 线 | 1 | 2 | 只 | 4.23 | 淘宝订单 3316403751043003789 | https://item.taobao.com/item.htm?id=672248125634 | 12 V 进盒，装在盒壁 | 店名写作 GX16。已购 2 只。开孔 Ø16
13 | 必要 | 连接 | BG16 防水插头 | 2 芯母插头，焊 1 m 线 | 1 | 2 | 条 | 7.31 | 淘宝订单 3316431687011003789 | https://item.taobao.com/item.htm?id=672248125634 | 12 V 适配器侧对插 | 店名写作 GX16。已购 2 条，实付 14.61 元
14 | 必要 | 连接 | 电源开关 | 圆形面板开关，12 V，触点 ≥5 A | 1 | 0 | 只 |  |  |  | 开关机，串在 BG16 之后的正极 | 购物记录未含，不估价格。装在电源口旁，开孔 Ø12
15 | 必要 | 指示 | 开机指示灯 | 绿色面板灯，12 V，自带电阻 | 1 | 0 | 只 |  |  |  | 开关接通后点亮 | 购物记录未含，不估价格。装在电源口旁
16 | 必要 | 指示 | 故障指示灯 | 红色面板灯，12 V，自带电阻 | 1 | 0 | 只 |  |  |  | 测值无效或供电异常时点亮 | 购物记录未含，不估价格。装在电源口旁，由主控经三极管驱动
17 | 必要 | 半导体 | 三极管 | S8050，NPN，TO-92 | 1 | 0 | 只 |  |  |  | 低边驱动故障灯 | 购物记录未含，不估价格。基极串 1 kΩ，发射极接 GND
18 | 必要 | 结构 | 防水盒 | 防水盒 | 1 | 2 | 只 | 7.02 | 设备清单（2）.xlsx |  | 主控安装
19 | 必要 | 结构 | 防水盒底板 | 底板 | 1 | 2 | 块 | 4.8 | 设备清单（2）.xlsx |  | 盒内安装 | 该行运费 8 元
20 | 必要 | 结构 | ESP32 外壳 | 开发板外壳 | 1 | 2 | 只 | 5 | 设备清单（2）.xlsx |  | 主控防护 | 该行运费 15 元
21 | 必要 | 紧固 | 尼龙铜柱 | 套装 | 1 | 2 | 套 | 33.77 | 设备清单（2）.xlsx |  | 板间支撑
22 | 必要 | 辅料 | 热缩管 | 四倍带胶，内径 4 mm，4 m，黑 | 1 | 1 | 卷 | 3.78 | 淘宝订单 3316403175061003789 | https://item.taobao.com/item.htm?id=659649511497 | 信号线绝缘 | 订单实付 14.51 元，含下列三种规格
23 | 必要 | 辅料 | 热缩管 | 四倍带胶，内径 6 mm，4 m，黑 | 1 | 1 | 卷 | 4.16 | 淘宝订单 3316403175061003789 | https://item.taobao.com/item.htm?id=659649511497 | 探头线绝缘
24 | 必要 | 辅料 | 热缩管 | 四倍带胶，内径 8 mm，2 m，黑 | 1 | 1 | 卷 | 3.48 | 淘宝订单 3316403175061003789 | https://item.taobao.com/item.htm?id=659649511497 | 电源线绝缘
25 | 必要 | 辅料 | 热缩管 | 四倍带胶，内径 12 mm，1 m，黑 | 1 | 1 | 卷 | 3.09 | 淘宝订单 3316403175061003789 | https://item.taobao.com/item.htm?id=659649511497 | 电源线绝缘
26 | 必要 | 3D打印 | 探头缸沿支架 | ProbeH_Bracket，水温 Ø8、TDS Ø10、pH Ø30 | 1 | 2 | 只 |  | docs/probe_h_bracket/stl/ProbeH_Bracket.stl |  | 三只探头安装 | 自制，无采购价。顶紧为打印 M8 螺纹，购物记录未单列金属螺丝
27 | 选购 | 传感 | 光照传感器 | BH1750FVI 数字光照模块 | 1 | 2 | 块 | 9.12 | 设备清单（2）.xlsx |  | 照度
28 | 选购 | 传感 | 超声波模块 | HC-SR04 | 1 | 2 | 只 | 3.92 | 设备清单（2）.xlsx |  | 水位 | 该行运费 2.5 元；ECHO 需 1 kΩ 与 2 kΩ 分压
29 | 选购 | 视觉 | ESP32-CAM | 开发板 + OV2640 摄像头 + 天线 | 1 | 1 | 套 | 50.8 | 淘宝订单 3316868401116022153 | https://item.taobao.com/item.htm?id=624976908079 | 图像采集 | 绿深旗舰店
30 | 选购 | 执行 | 四路继电器 | 5 V 光耦隔离 | 1 | 2 | 块 | 16.55 | 设备清单（2）.xlsx |  | 照明、加热、补水、投喂 | 低电平触发时上电须保持断开
31 | 选购 | 执行 | MOSFET 驱动模块 | IRF520 | 1 | 2 | 块 | 4.22 | 设备清单（2）.xlsx |  | 电磁阀低边驱动
32 | 选购 | 执行 | 二氧化碳电磁阀 | 12 V，含气管接头 | 1 | 2 | 套 | 57.42 | 设备清单（2）.xlsx |  | 二氧化碳供给
33 | 选购 | 执行 | 计泡器与止逆阀 | CO₂ 计泡器 + 止逆阀 | 1 | 2 | 套 | 53.46 | 设备清单（2）.xlsx |  | 气量观察与防回流
34 | 选购 | 执行 | 蠕动泵 | 12 V 微型蠕动泵 + 硅胶管 | 1 | 2 | 套 | 19.8 | 设备清单（2）.xlsx |  | 补水或加液
35 | 选购 | 电源 | 5 V 电源 | 5 V / 2 A | 0 | 2 | 只 | 5.19 | 设备清单（2）.xlsx |  | 调试备用 | 最小系统改由 12 V 经降压供电，本适配器不进入安装
36 | 选购 | 连接 | DC 电源母座 | DC005，5.5×2.5 mm，带线 | 0 | 3 | 只 | 2.1 | 淘宝订单 3316417466033058980 | https://item.taobao.com/item.htm?id=1045906676410 | 备用电源口 | 实付 6.30 元。最小系统电源口为 BG16
37 | 选购 | 总线 | TTL 转 RS485 | MAX13487，硬件自动方向 | 1 | 3 | 块 | 8.5 | 淘宝订单 3316849069024003789 | https://item.taobao.com/item.htm?id=1082100816221 | RS485 水质变送器 | 订单实付 35.50 元，另运费 10 元。模拟 pH/TDS 方案下不必安装
38 | 选购 | 存储 | TF 卡座 | Micro SD 转 SPI，焊接版 | 1 | 2 | 块 | 3.9 | 淘宝订单 3316848853047058980 | https://item.taobao.com/item.htm?id=1079782787295 | 主板历史记录
39 | 选购 | 存储 | TF 存储卡 | 飞利浦 16 GB MicroSD | 1 | 3 | 张 | 101.7 | 京东订单 3621441007253310 |  | 摄像头或主板记录 | 101.70 元为该订单 3 件合计；无商品页链接
40 | 选购 | 结构 | 超声波支架 | 亚克力 | 1 | 2 | 只 | 1.07 | 设备清单（2）.xlsx |  | HC-SR04 固定
41 | 选购 | 连接 | 杜邦扩展线 | 1 母拖 5 母，红，20 cm 量级 | 0 | 3 | 条 | 9 | 淘宝订单 3316402383056012971 | https://item.taobao.com/item.htm?id=1051888345759 | 电源分配 | 同单另有黑色 3 条
42 | 选购 | 连接 | 杜邦扩展线 | 1 母拖 5 母，黑 | 0 | 3 | 条 | 9 | 淘宝订单 3316402383056012971 | https://item.taobao.com/item.htm?id=1051888345759 | 电源分配 | 订单实付 76.20 元，含下列公头线
43 | 选购 | 连接 | 杜邦扩展线 | 1 母拖 5 公，黑 | 0 | 3 | 条 | 3.7 | 淘宝订单 3316402383056012971 | https://item.taobao.com/item.htm?id=1052424360279 | 信号分接
44 | 选购 | 连接 | 杜邦扩展线 | 1 母拖 5 公，红 | 0 | 3 | 条 | 3.7 | 淘宝订单 3316402383056012971 | https://item.taobao.com/item.htm?id=1052424360279 | 信号分接
45 | 选购 | 连接 | 杜邦胶壳套件 | 丢石头 2.54 mm 胶壳连接器套装 | 0 | 1 | 套 | 65 | 京东订单 3625441008697455 |  | 自制排线 | 无商品页链接
46 | 选购 | 连接 | BG12 防水接头 | 4 芯公母套装（公插座 + 母插头） | 2 | 0 | 套 | 1.48 | 淘宝订单 3316403751043003789 | https://item.taobao.com/item.htm?id=672248125634 | 光照、水位各 1 套出盒 | 与必要项同款。订单 10 套已计入必要栏，此处不重复计采购数量
47 | 选购 | 连接 | BG12 防水接头 | 2 芯公母套装（公插座 + 母插头） | 0 | 10 | 套 | 1.3 | 淘宝订单 3316403751043003789 | https://item.taobao.com/item.htm?id=672248125634 | 备用出线 | 店名写作 GX12
48 | 选购 | 连接 | BG12 防水接头 | 3 芯公母套装（公插座 + 母插头） | 0 | 4 | 套 | 1.39 | 淘宝订单 3316403751043003789 | https://item.taobao.com/item.htm?id=672248125634 | 备用出线 | 店名写作 GX12
49 | 选购 | 连接 | 防尘帽 | BG12，5 只装 | 0 | 5 | 包 | 1.32 | 淘宝订单 3316403751043003789 | https://item.taobao.com/item.htm?id=672248125634 | 闲置插座防护 | 店名写作 GX12
50 | 选购 | 连接 | 防尘帽 | BG16，5 只装 | 0 | 1 | 包 | 1.67 | 淘宝订单 3316403751043003789 | https://item.taobao.com/item.htm?id=672248125634 | 闲置插座防护 | 店名写作 GX16
51 | 选购 | 连接 | BG12 防水插头 | 2 芯母插头，焊 1 m 线 | 0 | 2 | 条 | 7.22 | 淘宝订单 3316403751043003789 | https://item.taobao.com/item.htm?id=672248125634 | 备用外部引线 | 店名写作 GX12
52 | 选购 | 连接 | Type-C 母座 | 6 焊点，带固定板，支持充电 | 0 | 10 | 只 | 0.53 | 淘宝订单 3316872001102003789 | https://item.taobao.com/item.htm?id=834736410877 | 供电或数据口改造 | 实付 7.10 元，运费 1.80 元
53 | 选购 | 连接 | PCB 接线端子 | KF128，2P，3.81 mm，铜扣铜针 | 0 | 6 | 只 | 0.22 | 淘宝订单 3317029860001003789 | https://item.taobao.com/item.htm?id=1042750428317 | 功率线接线 | 实付 3.32 元，运费 2.00 元
54 | 选购 | 无源器件 | 电阻 | 1/6 W 金属膜 2 kΩ 1%，100 只装 | 0 | 100 | 只 | 2.57 | 淘宝订单 3316401879043003789 | https://item.taobao.com/item.htm?id=609077395130 | 超声波回波分压 | 包装价。同单 1 kΩ 已列入必要，供故障灯
55 | 选购 | 无源器件 | 整流二极管 | 1N4007，20 只装 | 0 | 20 | 只 | 2.01 | 淘宝订单 3316401879043003789 | https://item.taobao.com/item.htm?id=614238411310 | 电磁阀续流 | 订单实付 7.15 元，含同单电阻
56 | 选购 | 辅料 | 三防漆 | 中山大田，透明，1 瓶 | 0 | 1 | 瓶 | 15.9 | 淘宝订单 3317023920027012971 | https://item.taobao.com/item.htm?id=776205367002 | 电路板防潮
57 | 选购 | 辅料 | UV 胶 | 焊点保护，透明稠款，50 g，配针头 | 0 | 1 | 支 | 11.46 | 拼多多-清单.jpg |  | 固定元件与排线 | 宇辰光官方旗舰店；标价 12.06 元，实付 11.46 元
58 | 选购 | 紧固 | 热熔铜螺母 | M3×4.0，外径 4.0 mm，200 个 | 0 | 200 | 个 | 8 | 拼多多-清单.jpg |  | 选购打印件预埋 | 科宝威；实付 8 元，无商品链接
59 | 选购 | 紧固 | 热熔铜螺母 | M3×5.0，外径 5.0 mm，200 个 | 0 | 200 | 个 | 12 | 拼多多-清单.jpg |  | 选购打印件预埋 | 科宝威；实付 12 元，无商品链接
60 | 选购 | 3D打印 | 单 TDS 缸沿支架 | TdsH_Bracket，Ø10 | 1 | 2 | 只 |  | docs/tds_h_bracket/stl/TdsH_Bracket.stl |  | 单独安装 TDS | 自制，无采购价。最小系统已含三探头合一支架
61 | 选购 | 3D打印 | 超声波缸沿支架 | SR04_Bracket | 1 | 2 | 只 |  | docs/sr04_bracket/stl/SR04_Bracket.stl |  | HC-SR04 安装 | 自制，无采购价。另有亚克力成品支架
62 | 选购 | 3D打印 | 光照传感器外壳 | GY30_Base + GY30_Lid | 1 | 2 | 套 |  | docs/gy30_case/stl/ |  | BH1750 防护 | 自制，无采购价
63 | 选购 | 3D打印 | 摄像头吊架 | CamHanger_Upper + CamHanger_Lower | 1 | 1 | 套 |  | docs/cam_hanger/ |  | 缸外摄像头固定 | 自制，无采购价
64 | 选购 | 3D打印 | USB 摄像头外壳 | CamCase_Body + Back + Arca | 1 | 1 | 套 |  | docs/usb_cam_case/stl/ |  | 摄像头防护 | 自制，无采购价
65 | 选购 | 3D打印 | 穿缸传感器支架 | 压板、格兰、缸沿夹与导轨，见 sensor_mounts | 1 | 1 | 套 |  | docs/sensor_mounts/stl/ |  | 探头穿缸安装 | 自制，无采购价。与缸沿支架二选一
66 | 选购 | 3D打印 | 密封圈 | SealRing 与 SealCap | 1 | 1 | 套 |  | docs/seal_ring/stl/ |  | 密封 | 自制，无采购价
67 | 选购 | 3D打印 | 喂食器打印件 | 转盘、壳体等，见 feeder/stl | 1 | 1 | 套 |  | docs/feeder/stl/ |  | 定量投喂机构 | 自制，无采购价。电机与继电器触点侧元件购物记录未单列
68 | 工具 | 安装 | 钻孔模板 | DrillGuide，玻璃孔位 Ø4.2 / 6 / 12 / 12.5 | 0 | 1 | 只 |  | docs/sensor_mounts/stl/DrillGuide.stl |  | 穿缸开孔定位 | 自制，无采购价
69 | 工具 | 测试 | 直流可调电源 | KUAIQU，带 OCP/OVP 报警 | 0 | 1 | 台 | 233 | 京东订单 3618441006061091 |  | 调试供电 | 京东订单列表未给出商品页链接
70 | 工具 | 测试 | 面包板 | 实验面包板 | 0 | 2 | 块 | 6.76 | 设备清单（2）.xlsx |  | 临时接线
71 | 工具 | 安装 | 剥线钳 | 绿林电工剥线钳 | 0 | 1 | 把 | 72.9 | 京东订单 3625441012267649 |  | 接线 | 无商品页链接
72 | 工具 | 安装 | 压线钳 | SN-2549，PH2.0 / XH2.54 / VH3.96 / JST | 0 | 1 | 把 | 15.5 | 拼多多-清单.jpg |  | 压制杜邦与 JST 端子 | CWGJ 五金工具旗舰店；无商品链接
73 | 工具 | 安装 | 锡渣盒 | 软硅胶烙铁架，蓝色 | 0 | 1 | 只 | 13 | 拼多多-清单.jpg |  | 焊接清洁 | 华舟五金制品厂；订单列表无商品链接
74 | 工具 | 安装 | 合金开孔器 | Ø12 mm | 0 | 1 | 支 | 6.37 | 拼多多-清单.jpg |  | 外壳开孔 | 人民电器；标价 6.7 元，实付 6.37 元
75 | 工具 | 安装 | 合金开孔器 | Ø16 mm | 0 | 1 | 支 | 7.5 | 拼多多-清单.jpg |  | 外壳开孔 | 人民电器；标价约 7.9 元，实付 7.5 元

Sheet: 分类汇总
区分 | 条目数 | 采购数量合计
必要
选购
工具
合计

Sheet: 编制说明
项目 | 说明
标题 | iAquaria 样机物料清单
必要 | 安装水温、TDS 和 pH 最小系统所需的全部采购件。外部 12 V 经二芯 BG16 进盒，三只传感器各用一套四芯 BG12 出盒。电源口旁设开关、绿色开机灯和红色故障灯；盒内用 LM2596 降至 5 V。
十套 | 最小系统文件按 10 套计算。单件按单套用量乘 10，故四芯 BG12 为 30 套。热缩管 10 套共用 1 卷。4.7 kΩ 与 1 kΩ 按安装只数计用量，金额按 1 包包装价。开关、指示灯和三极管购物记录中没有，不估价格。
选购 | 最小系统以外的电子元件、耗材和 3D 打印件。包括光照、水位、摄像头、继电器、电磁阀、泵、12 V 供电、RS485、存储、面板接插件，以及对应外壳和支架。
工具 | 安装和测试所用的工具与仪器，不装入样机。包括可调电源、面包板、剥线钳、压线钳、锡渣盒、开孔器和钻孔模板。
价格 | 单价取自对应购物记录。包装出售的电阻、二极管按包装标价，不拆成单只成本。3D 打印件为自制，不填写估价。
链接 | 淘宝保留商品页链接。京东订单列表和拼多多订单截图只有商品名与实付金额，没有商品页地址。打印件来源写仓库内 STL 路径。
未列入 | 京东订单中的华为手表、药品、威纶通触摸屏下载线和碱性电池与本系统无关，未列入。交易关闭的 12 V 电源 1 只未计入采购数量。喂食器电机、续流二极管和保险电阻在购物记录中没有对应行。
固件 | 现行主控固件按 RS485 变送器读取 TDS 与 pH。购物记录中的测量件是 DFRobot 模拟模块。若现场改用 RS485 变送器，MAX13487 改为必要，模拟模块改为备件。
