Brigchen/iAquaria/docs/设备清单（2）.xlsx

类别 | 设备名称 | 说明 | 数量 | 单价 | 运费
环境传感采集类 | DS18B20 | 防水型不锈钢探头（1米线，水温温度传感器） | 2 | 6
环境传感采集类 | DFRobot SEN0161 模拟pH计V2 | 配套探头，pH传感器 | 2 | 177.5
环境传感采集类 | DFRobot SEN0244 模拟TDS传感器 | TDS水质检测 | 2 | 96 | 5
环境传感采集类 | BH1750FVI 数字光照强度传感器模块 | 光照检测 | 2 | 9.12
环境传感采集类 | HC-SR04 超声波测距模块 | 水位检测 | 2 | 3.92 | 2.5
主控类 | ESP32-DevKitC V4(ESP32-WROOM-32E) | 开发板 | 2 | 68 | 15
电控驱动器件 | 4路继电器模块 | 5V光耦隔离 | 2 | 16.55
电控驱动器件 | IRF520 MOSFET驱动模块 | 场效应管驱动 | 2 | 4.22
生态调控执行器件 | 12V CO₂电磁阀 + 气管接头 | CO₂供给控制 | 2 | 57.42
生态调控执行器件 | CO₂计泡器 + 止逆阀 | CO₂流量监测与防回流 | 2 | 53.46
生态调控执行器件 | 12V微型蠕动泵 + 硅胶管 | 液体精准输送 | 2 | 19.8
结构供电辅料耗材 | 杜邦线 | 10cm | 1 | 8.76
 |  | 21cm | 1 | 9.87
 | 面包板 | 接线 | 2 | 6.76
 | 5V2A电源 | 供电 | 2 | 5.19
 | 防水盒 | 防水盒 | 2 | 7.02
 |  | 防水盒底板 | 2 | 4.8 | 8
 | 亚克力支架 | 超声波支架 | 2 | 1.07
 |  | esp32外壳 | 2 | 5 | 15
 |  | 尼龙铜柱 | 2 | 33.77
