Brigchen/iAquaria/docs/report_assets/fig_cost.png

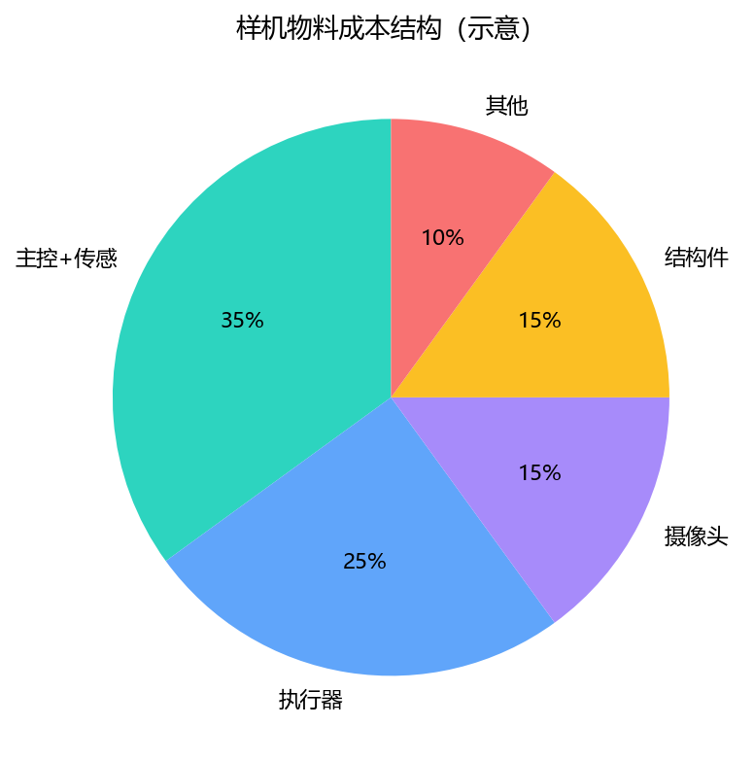
docs/report_assets/fig_cost.png
