Brigchen/iAquaria/docs/拼多多-清单.jpg

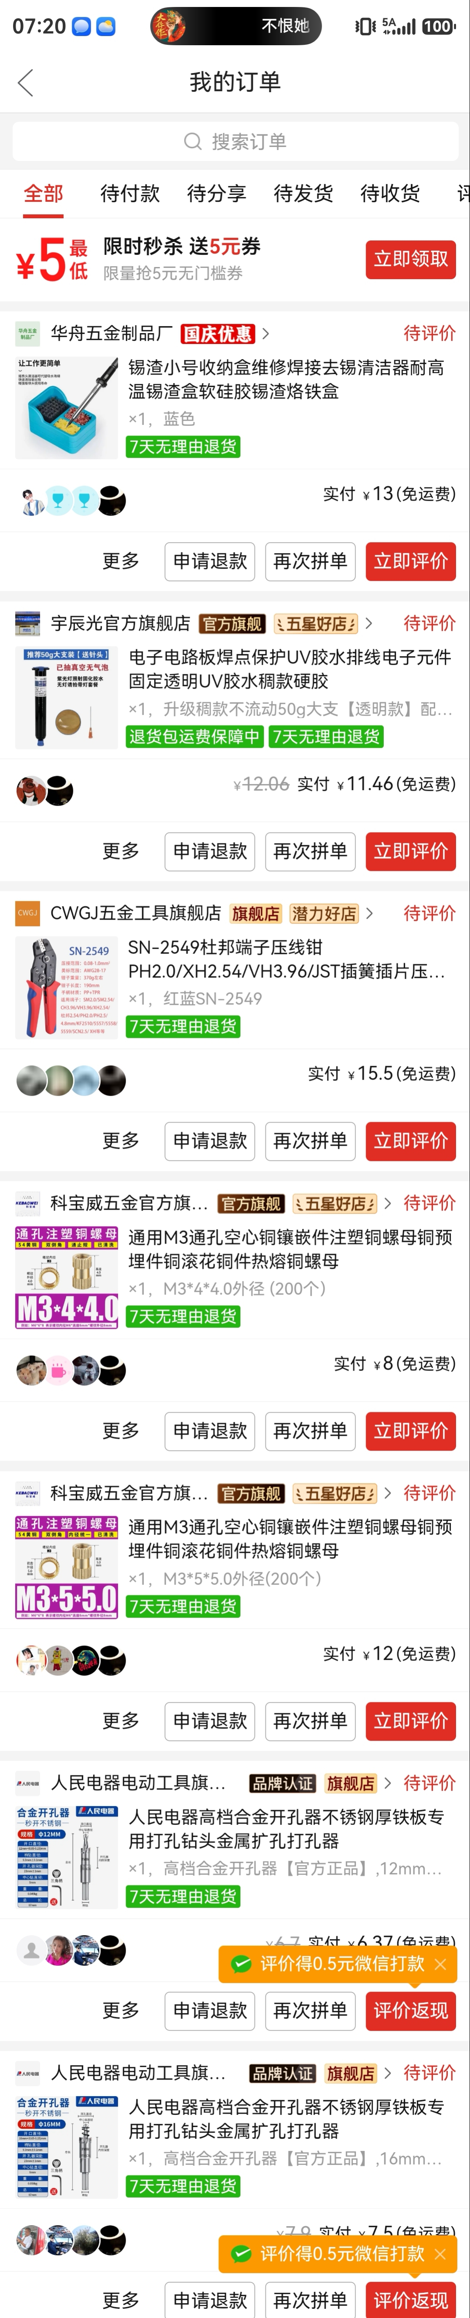
docs/拼多多-清单.jpg
