Brigchen/iAquaria/docs/cam_hanger/iAqua_CamHanger-CamHanger_M8_pad.stl

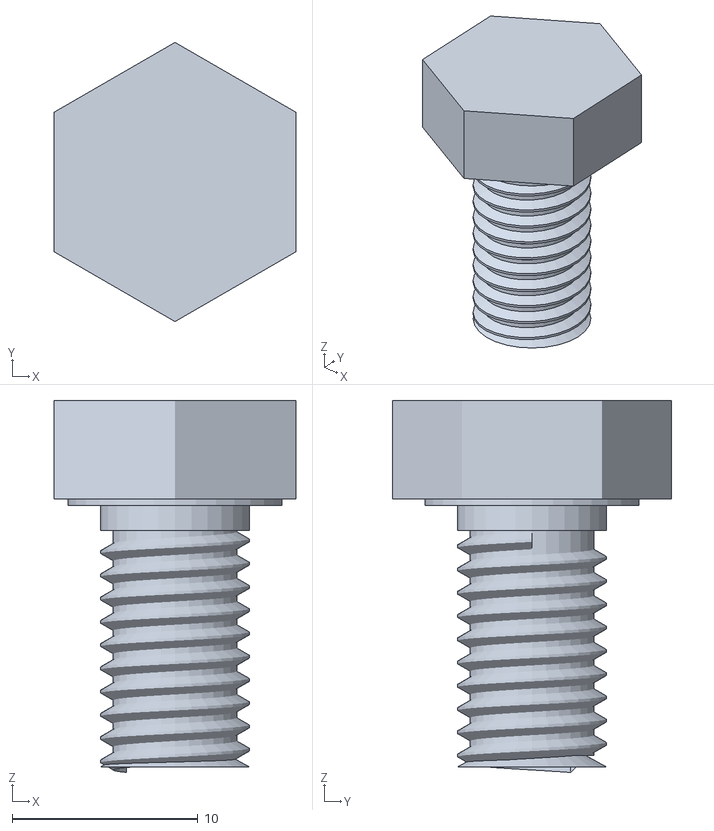
[picture p85: CAD file, 2026-09-29]
docs/cam_hanger/iAqua_CamHanger-CamHanger_M8_pad.stl
13.0 x 15.0 x 20.0
