Brigchen/iAquaria/docs/cam_hanger/stl/CamHanger_Upper.stl

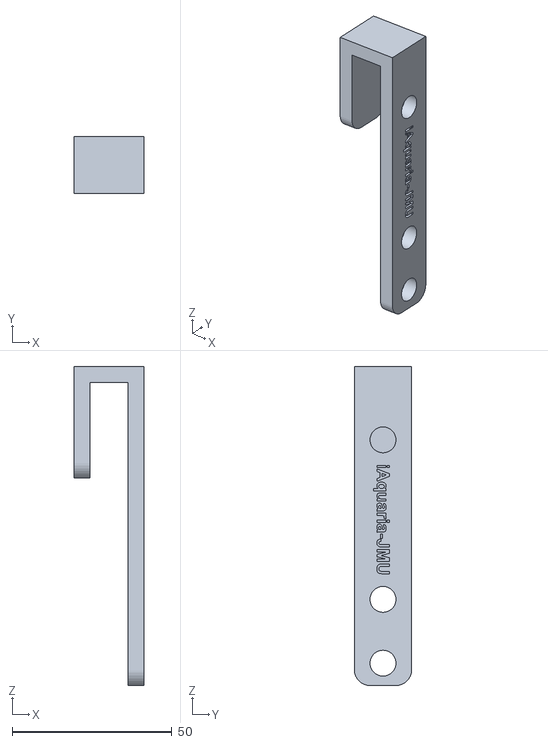
[picture p86: CAD file, 2026-09-29]
docs/cam_hanger/stl/CamHanger_Upper.stl
22.0 x 18.0 x 100.0
