Brigchen/iAquaria/docs/feeder/stl/Housing.stl

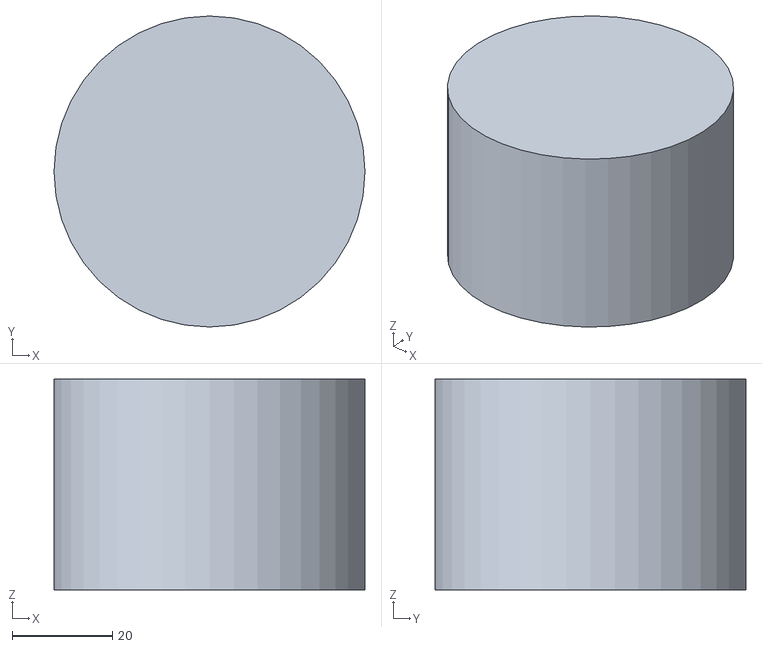
[picture p87: CAD file, 2026-09-29]
docs/feeder/stl/Housing.stl
62.0 x 62.0 x 42.0
