Brigchen/iAquaria/docs/gy30_case/iAqua_GY30_Case-GY30_Base.3mf

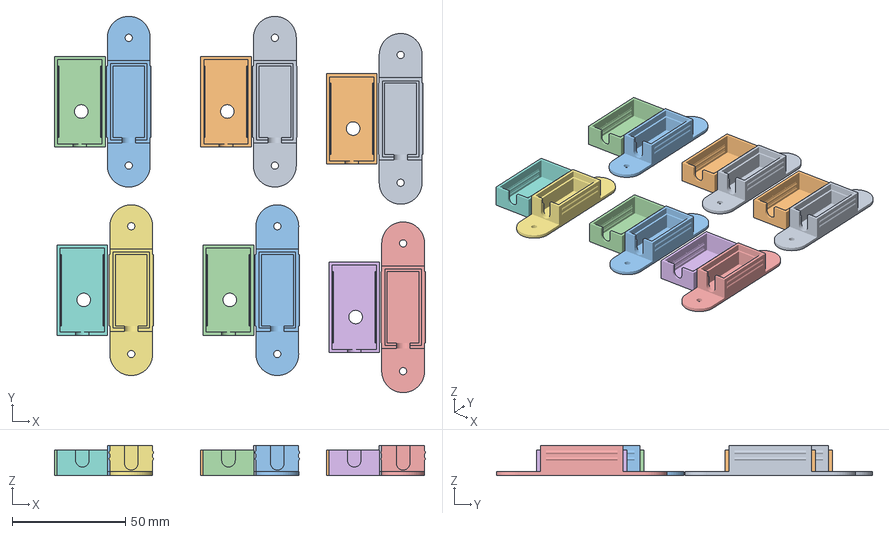
[picture p88: CAD file, 2026-09-29]
docs/gy30_case/iAqua_GY30_Case-GY30_Base.3mf
163.7 x 166.1 x 13.3 mm
iAqua_GY30_Case-GY30_Base.stl x 6
iAqua_GY30_Case-GY30_Lid.stl x 6
