Brigchen/iAquaria/docs/gy30_case/stl/GY30_Lid.stl

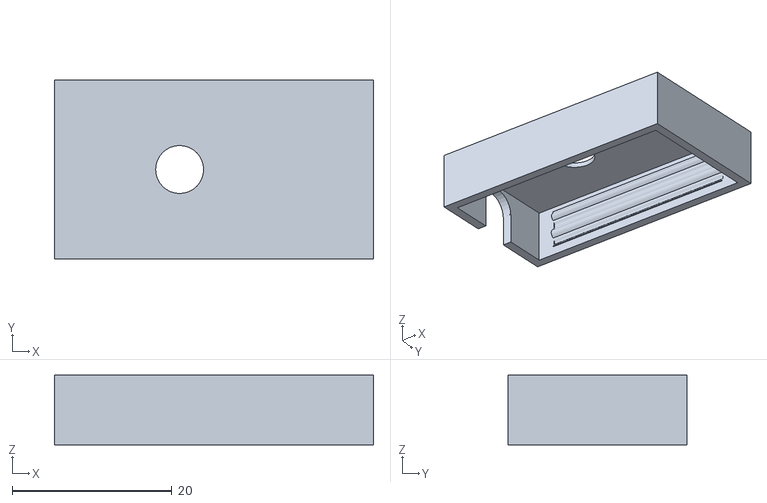
[picture p89: CAD file, 2026-09-29]
docs/gy30_case/stl/GY30_Lid.stl
39.9 x 22.4 x 8.75
