Brigchen/iAquaria/docs/ph_KWL_PO_01A_case/electro_box_IP65.stl

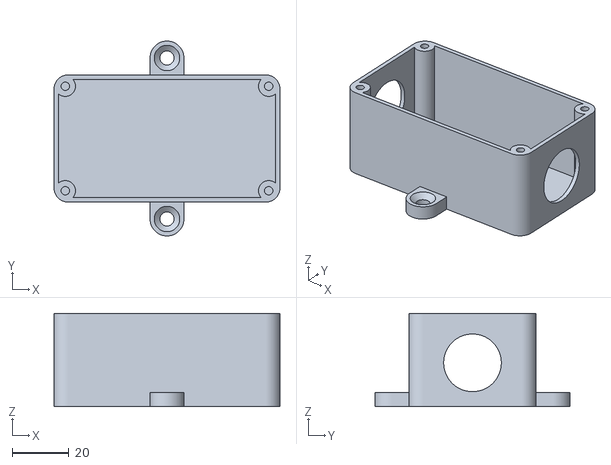
[picture p90: CAD file, 2026-10-14]
docs/ph_KWL_PO_01A_case/electro_box_IP65.stl
80.0 x 69.0 x 33.0
