Brigchen/iAquaria/docs/probe_h_bracket/stl/ProbeH_Bracket.stl

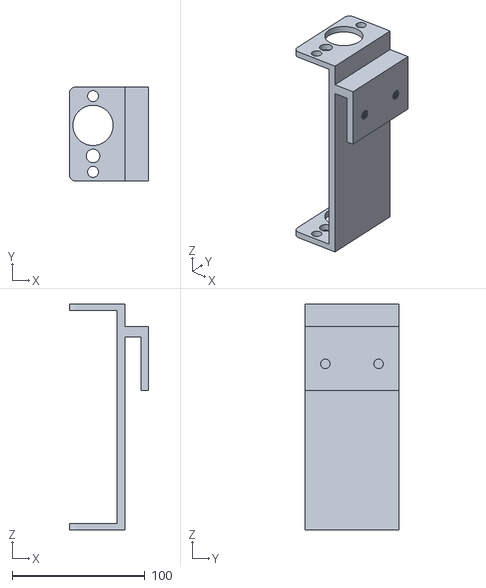
[picture p91: CAD file, 2026-09-29]
docs/probe_h_bracket/stl/ProbeH_Bracket.stl
59.8 x 70.8 x 170.0
