Brigchen/iAquaria/docs/seal_ring/stl/SealRing.stl

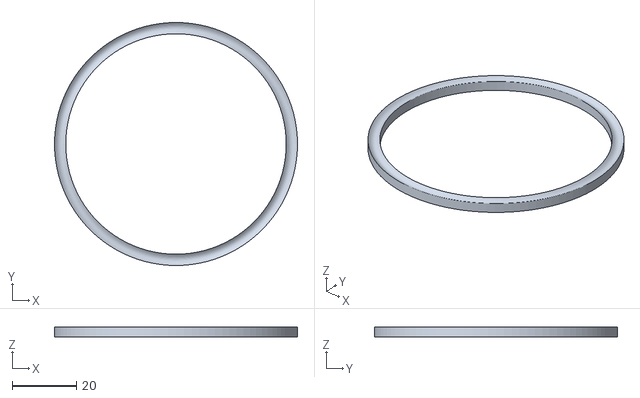
[picture p92: CAD file, 2026-09-29]
docs/seal_ring/stl/SealRing.stl
75.5 x 75.5 x 3.00
