Brigchen/iAquaria/docs/sensor_mounts/stl/Mount_BH1750.stl

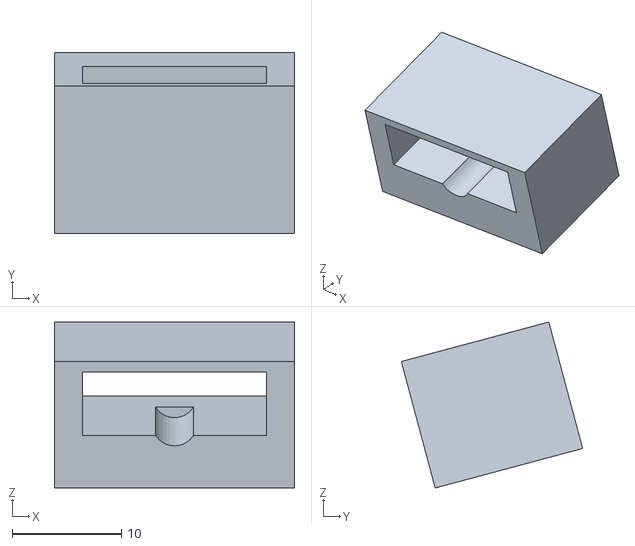
[picture p93: CAD file, 2026-09-29]
docs/sensor_mounts/stl/Mount_BH1750.stl
22.0 x 16.6 x 15.2
