Brigchen/iAquaria/docs/sr04_bracket/iAqua_SR04_Bracket-SR04_Bracket.stl

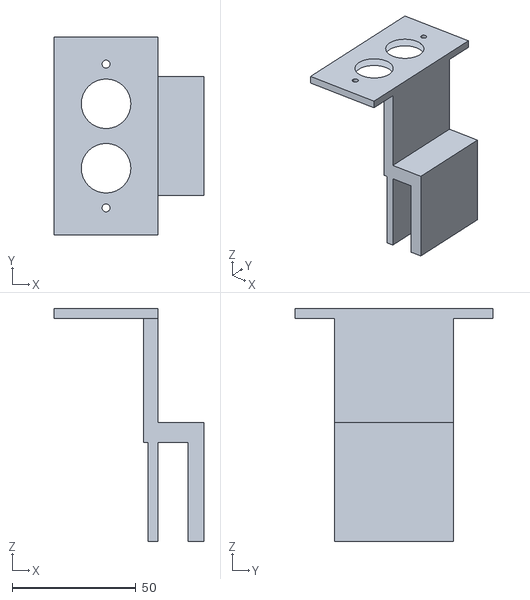
[picture p94: CAD file, 2026-09-29]
docs/sr04_bracket/iAqua_SR04_Bracket-SR04_Bracket.stl
60.5 x 80.0 x 94.0
