Brigchen/iAquaria/docs/tds_h_bracket/stl/TdsH_Bracket.stl

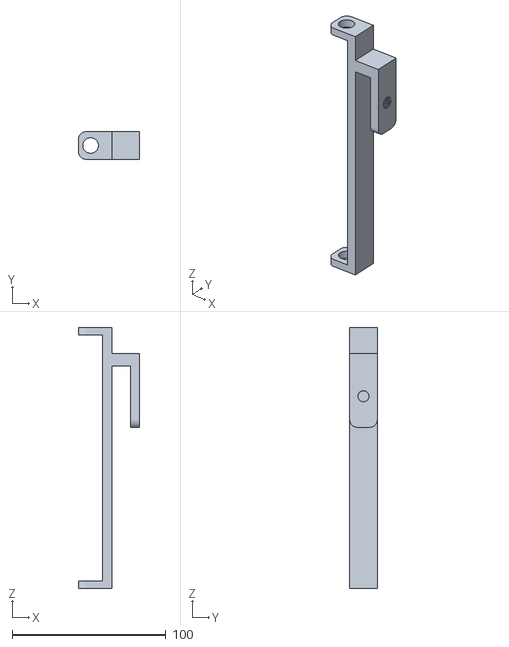
[picture p95: CAD file, 2026-09-29]
docs/tds_h_bracket/stl/TdsH_Bracket.stl
39.8 x 18.0 x 170.0
