Brigchen/iAquaria/docs/usb_cam_case/iAqua_UsbCamCase-外壳上盖.stl

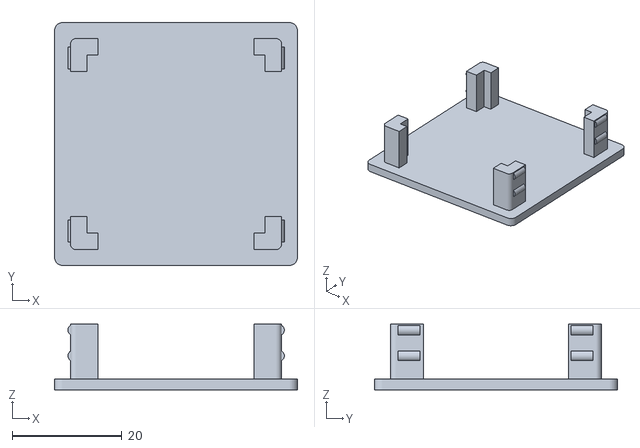
[picture p96: CAD file, 2026-09-29]
docs/usb_cam_case/iAqua_UsbCamCase-外壳上盖.stl
44.2 x 44.2 x 12.0
