Brigchen/iAquaria/docs/usb_cam_case/stl/CamCase_Body.stl

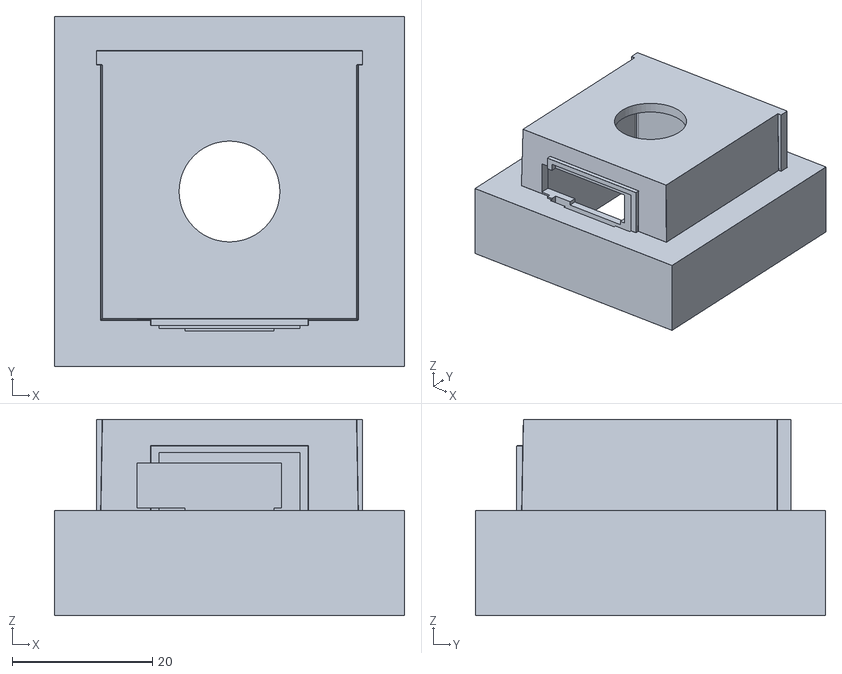
[picture p97: CAD file, 2026-09-29]
docs/usb_cam_case/stl/CamCase_Body.stl
50.0 x 50.0 x 28.0
