Brigchen/iAquaria/docs/cam_hanger/iAqua_CamHanger-CamH_Wall-mount.stl

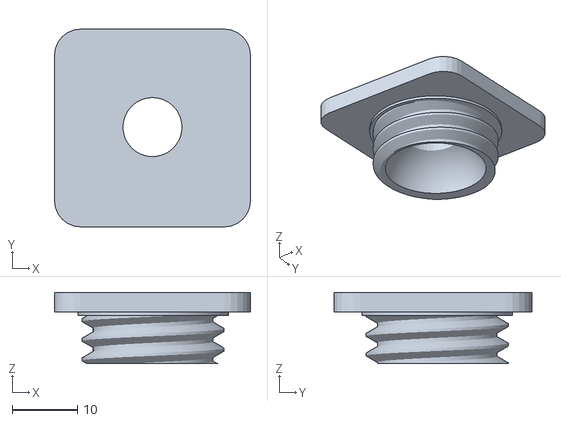
[picture p98: CAD file, 2026-09-29]
docs/cam_hanger/iAqua_CamHanger-CamH_Wall-mount.stl
30.0 x 30.3 x 10.9
