Brigchen/iAquaria/docs/cam_hanger/stl/CamHanger_Lower.stl

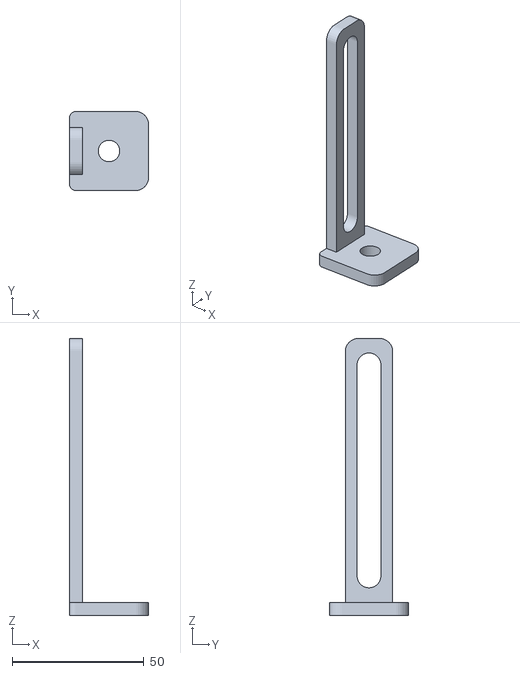
[picture p99: CAD file, 2026-09-29]
docs/cam_hanger/stl/CamHanger_Lower.stl
30.0 x 30.0 x 105.0
