Brigchen/iAquaria/docs/feeder/stl/Disc.stl

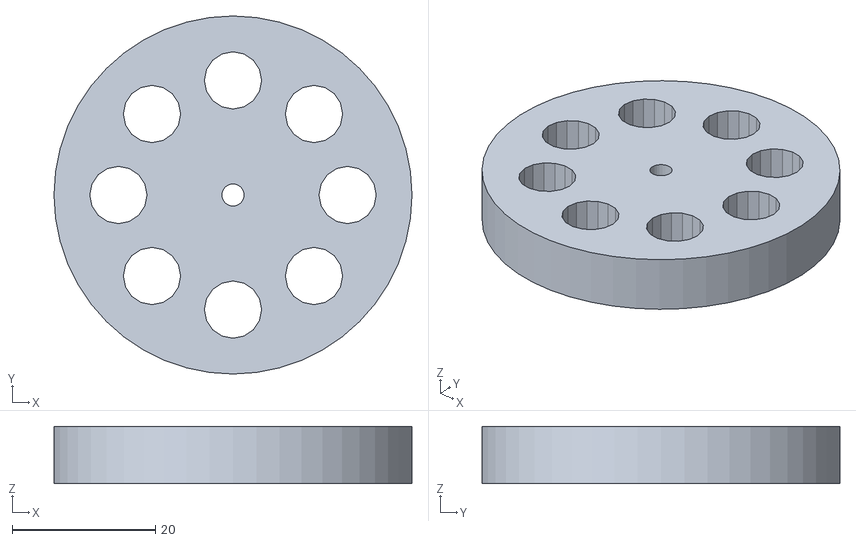
[picture p100: CAD file, 2026-09-29]
docs/feeder/stl/Disc.stl
50.0 x 50.0 x 8.00
