Brigchen/iAquaria/docs/gy30_case/iAqua_GY30_Case-GY30_Lid.stl

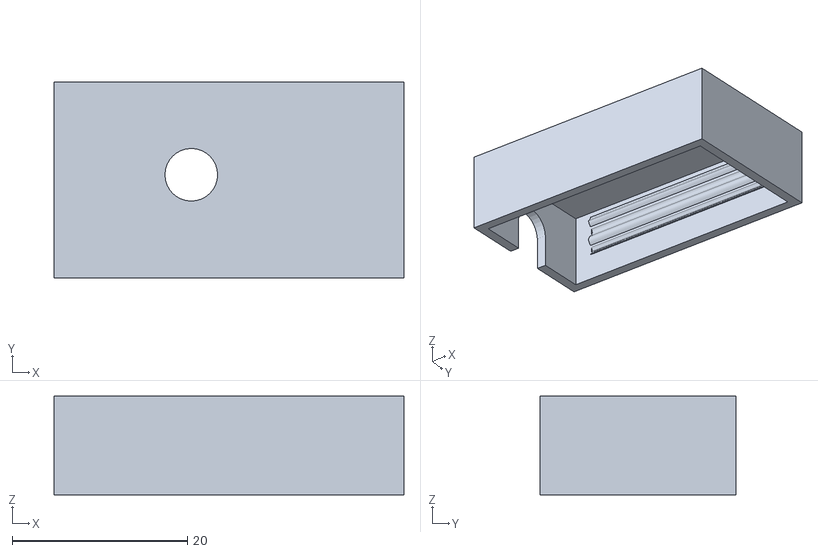
[picture p101: CAD file, 2026-09-29]
docs/gy30_case/iAqua_GY30_Case-GY30_Lid.stl
39.9 x 22.4 x 11.3
