Brigchen/iAquaria/docs/gy30_case/stl/GY30_Base.stl

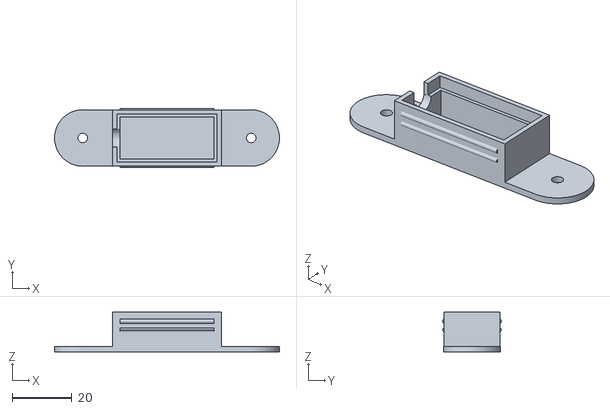
[picture p102: CAD file, 2026-09-29]
docs/gy30_case/stl/GY30_Base.stl
75.3 x 19.7 x 13.3
