Brigchen/iAquaria/docs/ph_KWL_PO_01A_case/electro box2_1.stl

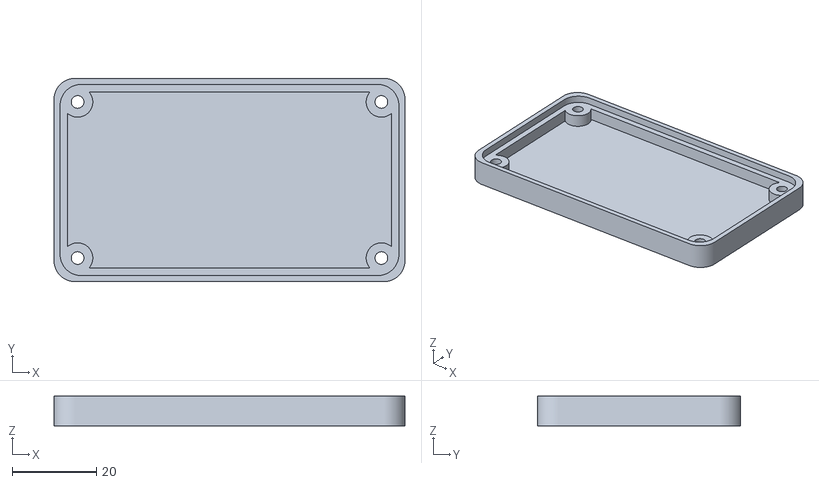
[picture p103: CAD file, 2026-10-14]
docs/ph_KWL_PO_01A_case/electro box2_1.stl
83.2 x 48.2 x 7.00
