Brigchen/iAquaria/docs/seal_ring/stl/SealRing_68.75.stl

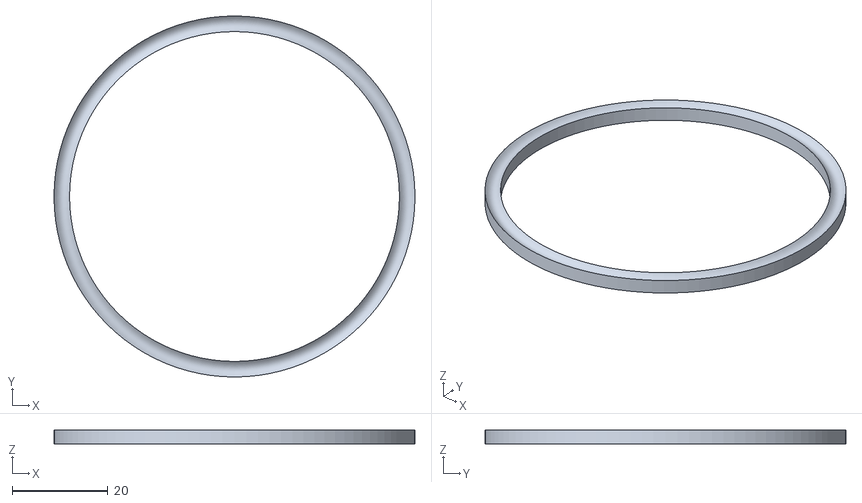
[picture p104: CAD file, 2026-09-29]
docs/seal_ring/stl/SealRing_68.75.stl
75.2 x 75.2 x 3.00
