Brigchen/iAquaria/docs/sensor_mounts/stl/RimClip_Jaw.stl

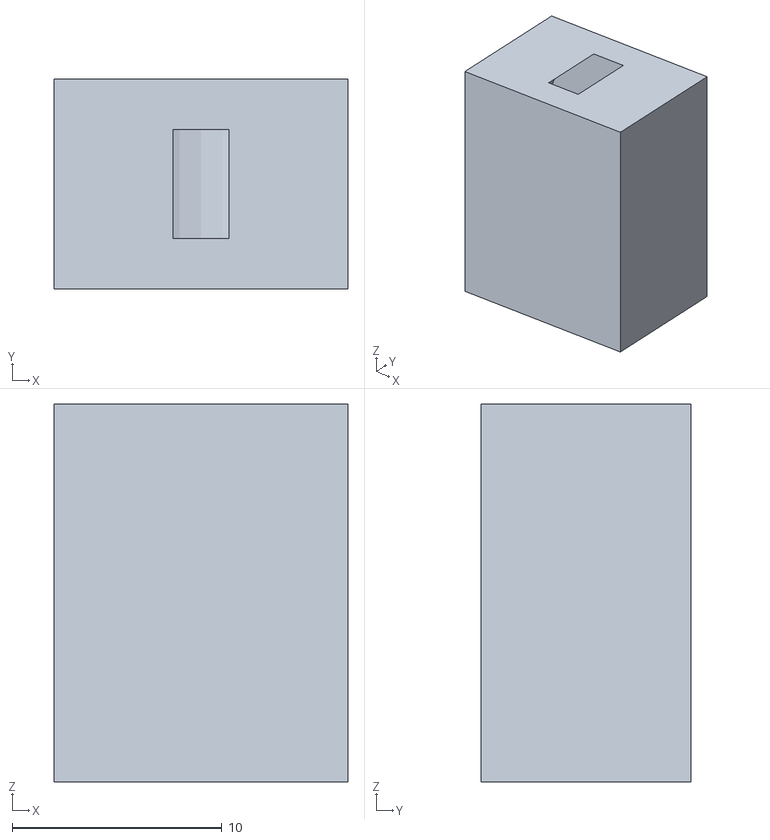
[picture p105: CAD file, 2026-09-29]
docs/sensor_mounts/stl/RimClip_Jaw.stl
14.0 x 10.0 x 18.0
