Brigchen/iAquaria/docs/usb_cam_case/iAqua_UsbCamCase-外壳底盒.stl

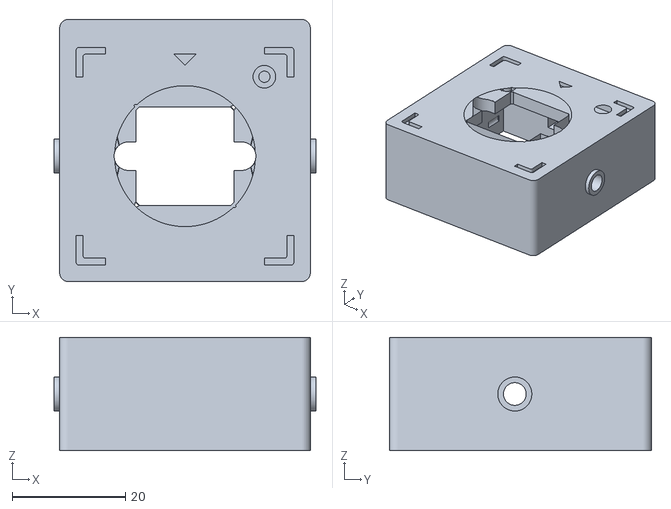
[picture p106: CAD file, 2026-09-29]
docs/usb_cam_case/iAqua_UsbCamCase-外壳底盒.stl
46.2 x 46.2 x 20.0
