Brigchen/iAquaria/docs/usb_cam_case/stl/CamCase_Arca.stl

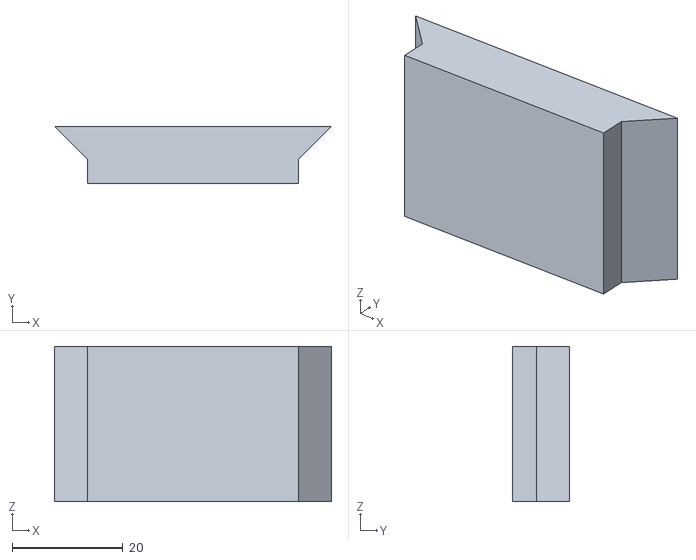
[picture p107: CAD file, 2026-09-29]
docs/usb_cam_case/stl/CamCase_Arca.stl
50.0 x 10.3 x 28.0
