Brigchen/iAquaria/docs/cam_hanger/iAqua_CamHanger-CamHanger_M8_0.stl

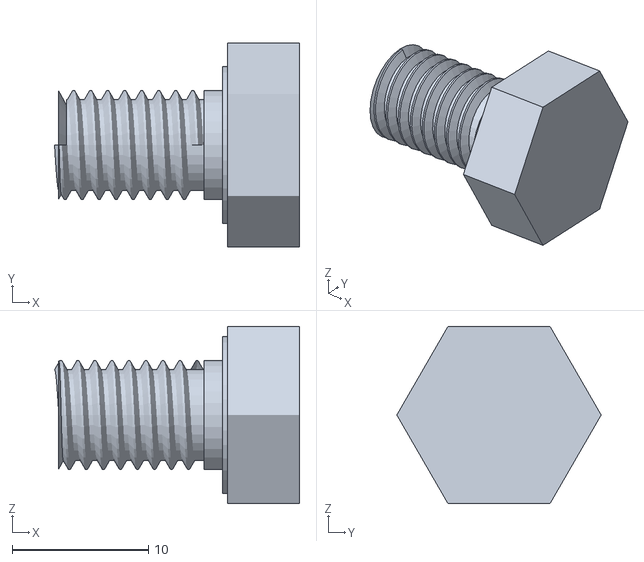
[picture p108: CAD file, 2026-09-29]
docs/cam_hanger/iAqua_CamHanger-CamHanger_M8_0.stl
18.0 x 15.0 x 13.0
