Brigchen/iAquaria/docs/feeder/stl/MotorMount.stl

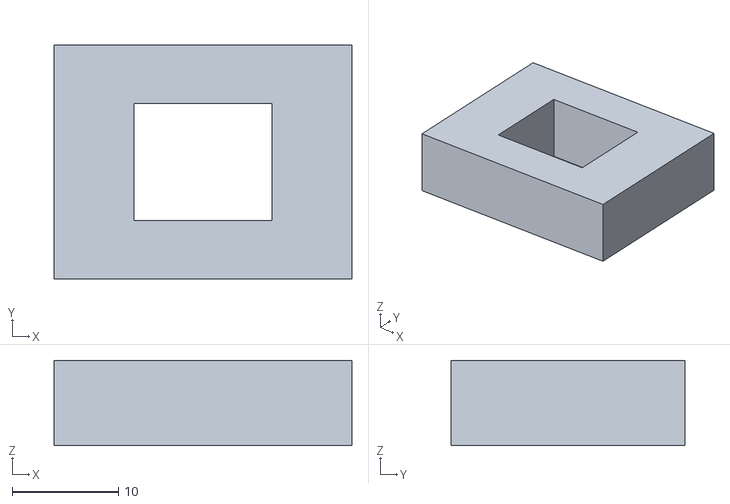
[picture p109: CAD file, 2026-09-29]
docs/feeder/stl/MotorMount.stl
28.0 x 22.0 x 8.00
