Brigchen/iAquaria/docs/ph_KWL_PO_01A_case/pH_KWL_PO_01A_case-electro box2_1.stl

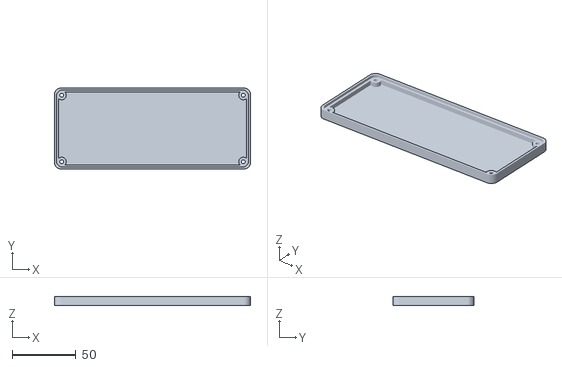
[picture p110: CAD file, 2026-10-14]
docs/ph_KWL_PO_01A_case/pH_KWL_PO_01A_case-electro box2_1.stl
153.2 x 63.2 x 7.00
