Brigchen/iAquaria/docs/seal_ring/stl/SealCap.stl

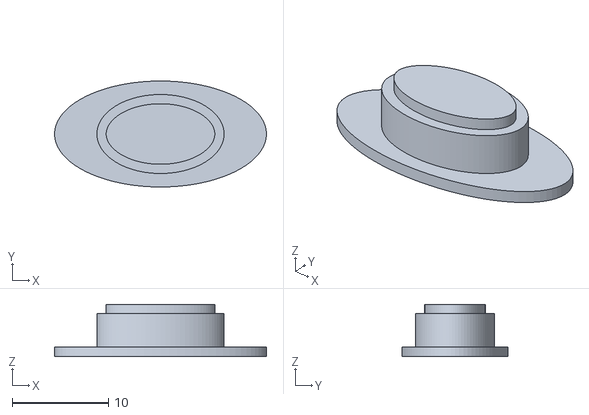
[picture p111: CAD file, 2026-09-29]
docs/seal_ring/stl/SealCap.stl
22.0 x 11.0 x 5.40
