Brigchen/iAquaria/docs/sensor_mounts/stl/RimClip.stl

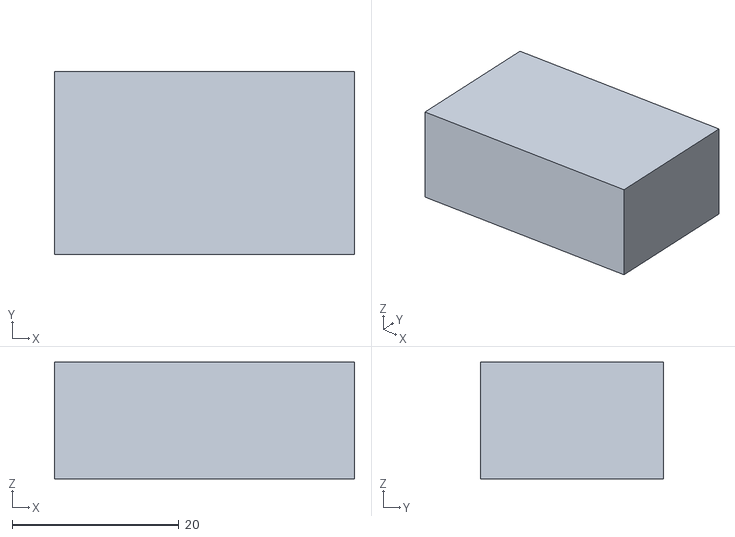
[picture p112: CAD file, 2026-09-29]
docs/sensor_mounts/stl/RimClip.stl
36.0 x 22.0 x 14.0
