Brigchen/iAquaria/docs/sr04_bracket/stl/SR04_Bracket.stl

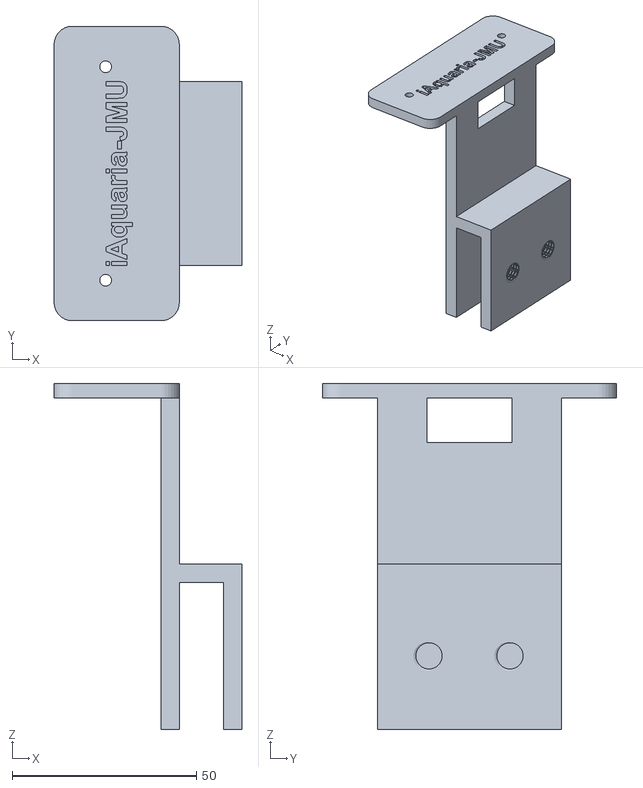
[picture p113: CAD file, 2026-09-29]
docs/sr04_bracket/stl/SR04_Bracket.stl
51.0 x 80.0 x 94.0
