Brigchen/iAquaria/docs/usb_cam_case/iAqua_UsbCamCase-lens_barcel.stl

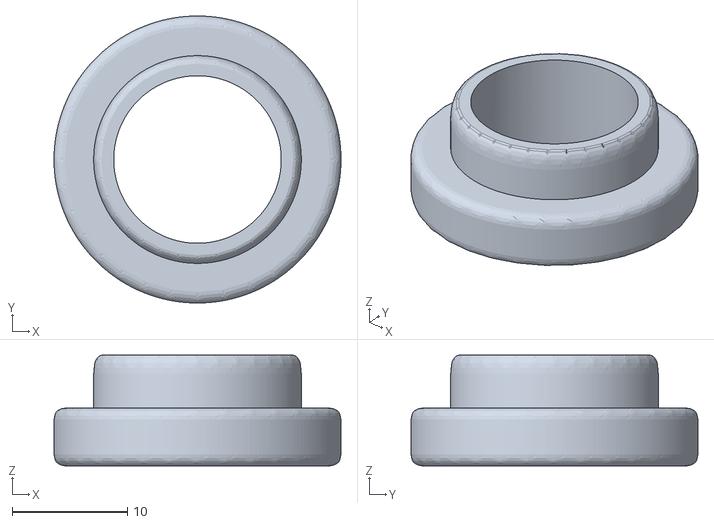
[picture p114: CAD file, 2026-09-29]
docs/usb_cam_case/iAqua_UsbCamCase-lens_barcel.stl
24.9 x 24.9 x 9.59
