Brigchen/iAquaria/docs/usb_cam_case/stl/外壳上盖.stl

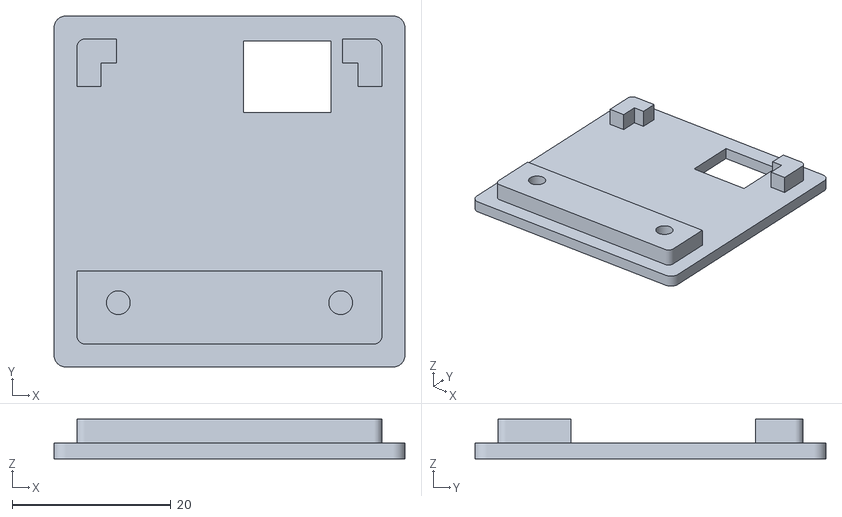
[picture p115: CAD file, 2026-09-29]
docs/usb_cam_case/stl/外壳上盖.stl
44.2 x 44.2 x 5.00
