Brigchen/iAquaria/docs/feeder/stl/Clamp.stl

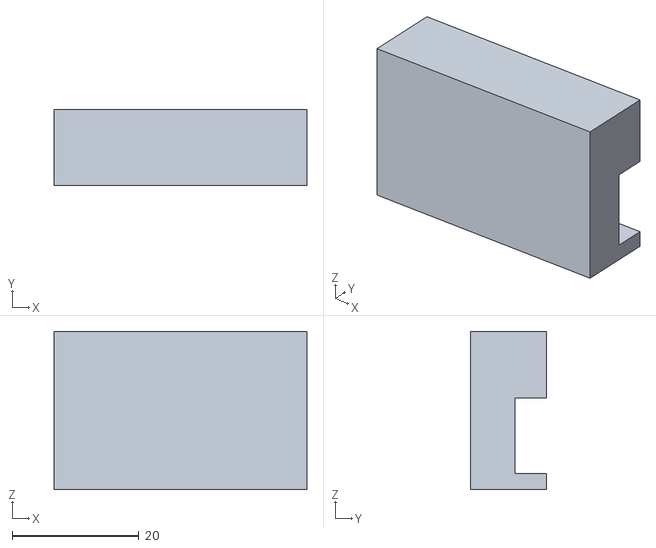
[picture p116: CAD file, 2026-09-29]
docs/feeder/stl/Clamp.stl
40.0 x 12.0 x 25.0
