Brigchen/iAquaria/docs/ph_KWL_PO_01A_case/pH_KWL_PO_01A_case-electro_box_IP65.stl

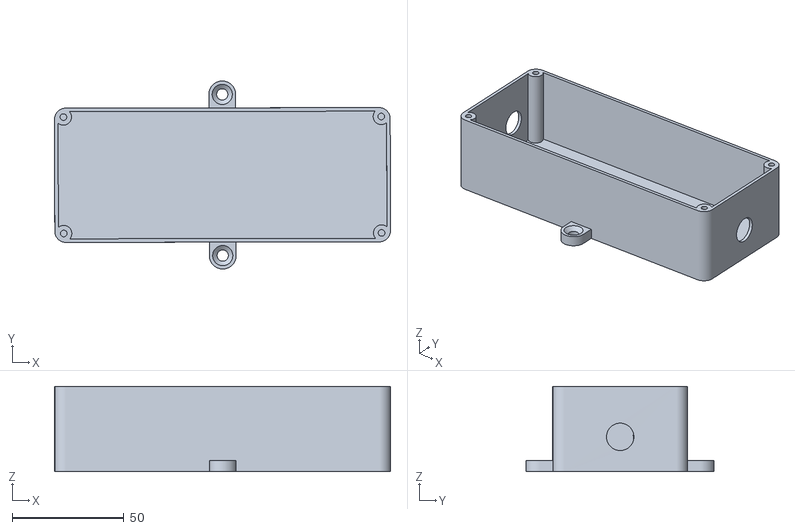
[picture p117: CAD file, 2026-10-14]
docs/ph_KWL_PO_01A_case/pH_KWL_PO_01A_case-electro_box_IP65.stl
150.1 x 84.0 x 38.0
