Brigchen/iAquaria/docs/sensor_mounts/stl/Bulkhead_4Port_Inner.stl

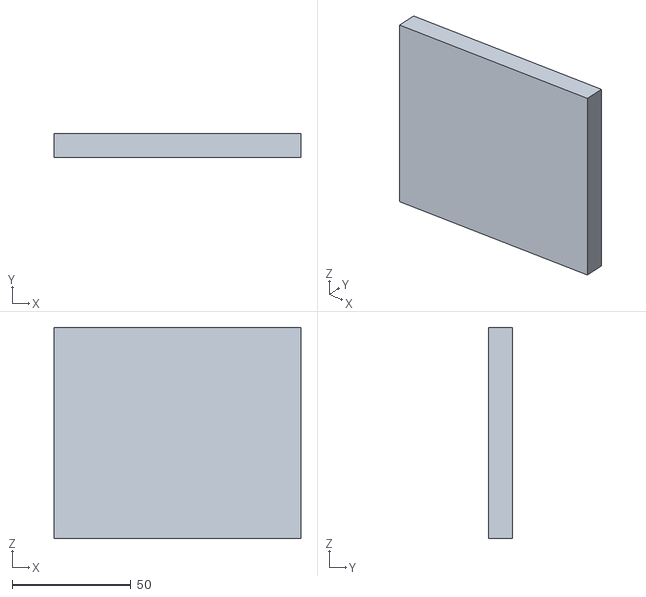
[picture p118: CAD file, 2026-09-29]
docs/sensor_mounts/stl/Bulkhead_4Port_Inner.stl
104.0 x 10.0 x 89.0
