Brigchen/iAquaria/docs/usb_cam_case/stl/CamCase_Barrel14.stl

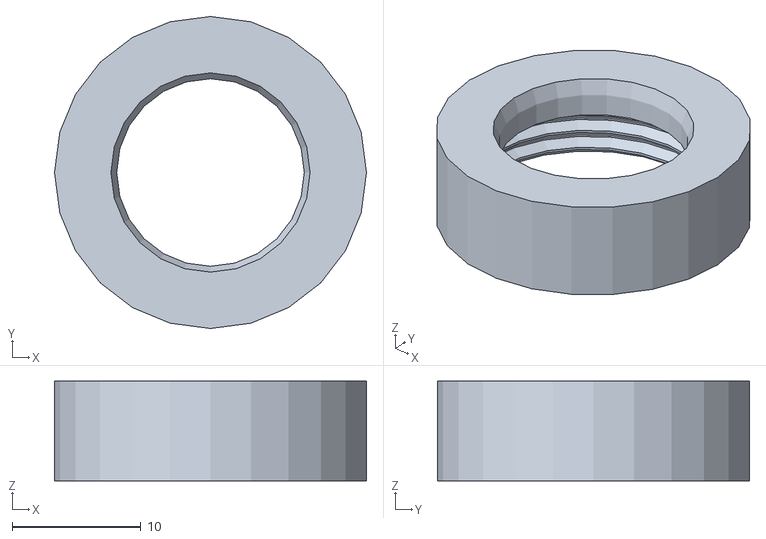
[picture p119: CAD file, 2026-09-29]
docs/usb_cam_case/stl/CamCase_Barrel14.stl
24.2 x 24.2 x 7.75
