Brigchen/iAquaria/docs/cam_hanger/iAqua_CamHanger-CamHanger_M8_clamp.stl

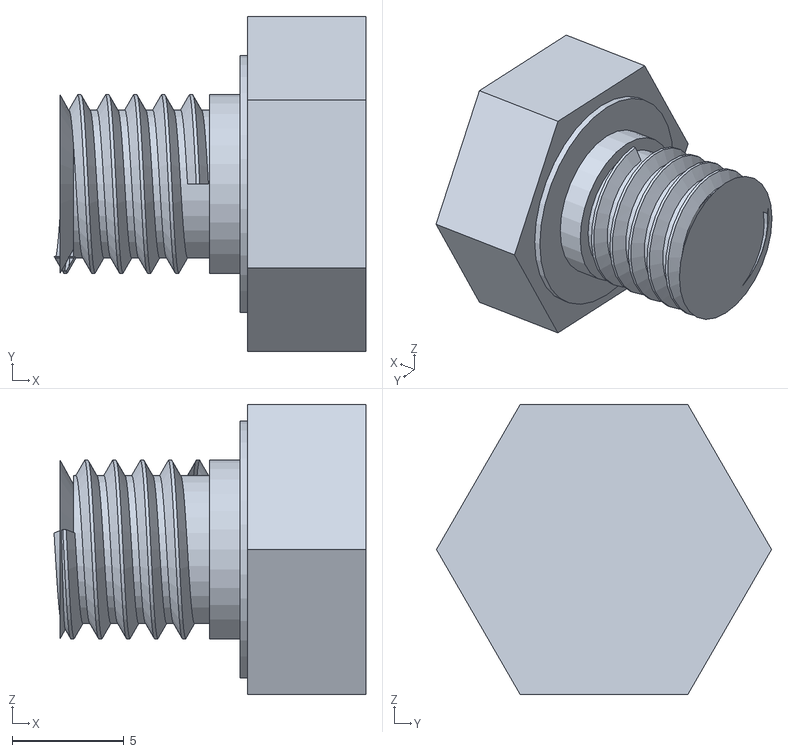
[picture p120: CAD file, 2026-09-29]
docs/cam_hanger/iAqua_CamHanger-CamHanger_M8_clamp.stl
14.0 x 15.0 x 13.0
