Brigchen/iAquaria/docs/feeder/stl/Lid.stl

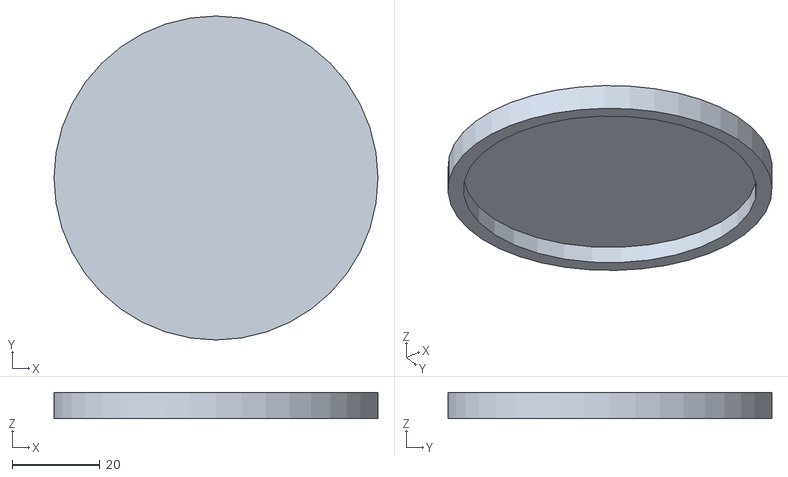
[picture p121: CAD file, 2026-09-29]
docs/feeder/stl/Lid.stl
74.0 x 74.0 x 6.00
