Brigchen/iAquaria/docs/sensor_mounts/stl/Gland_6mm.stl

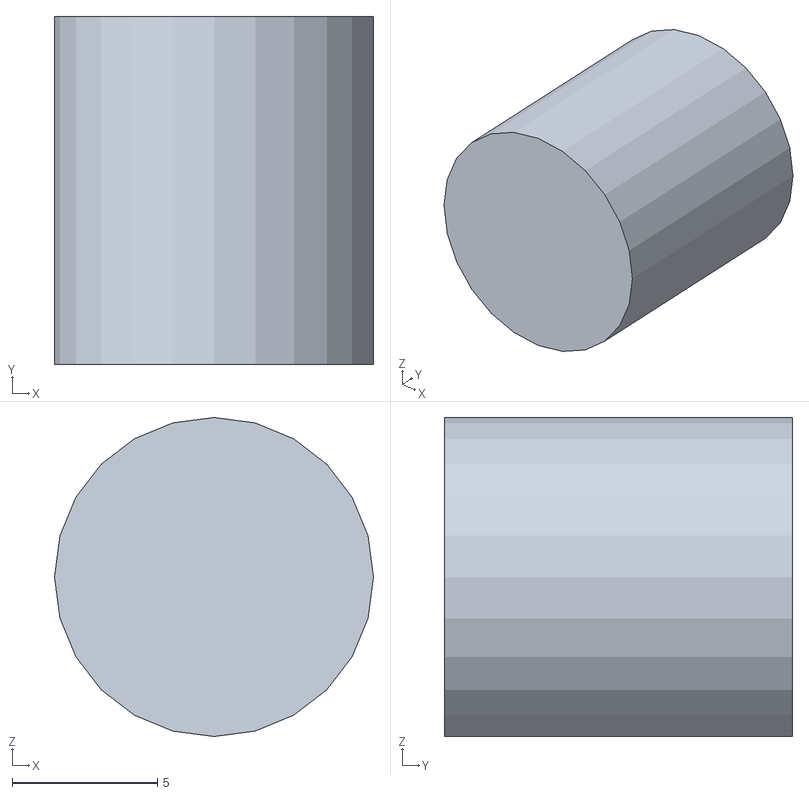
[picture p122: CAD file, 2026-09-29]
docs/sensor_mounts/stl/Gland_6mm.stl
11.0 x 12.0 x 11.0
