Brigchen/iAquaria/docs/usb_cam_case/stl/CamCase_Back.stl

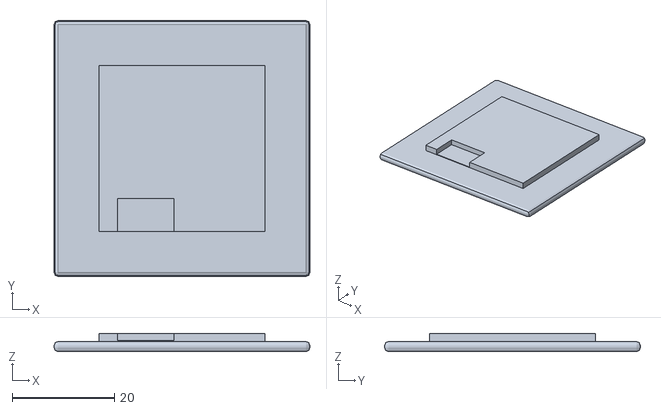
[picture p123: CAD file, 2026-09-29]
docs/usb_cam_case/stl/CamCase_Back.stl
50.0 x 50.0 x 3.60
