Brigchen/iAquaria/docs/cam_hanger/iAqua_CamHanger-CamHanger_Upper.stl

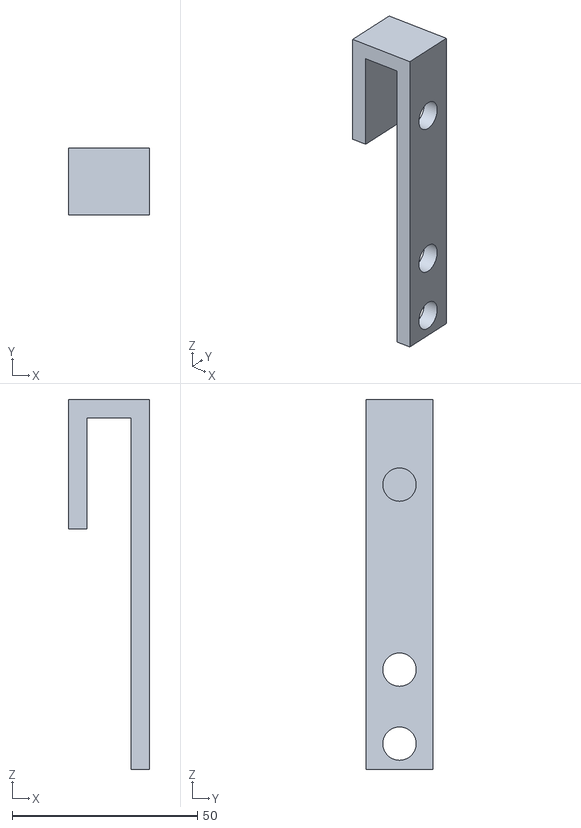
[picture p124: CAD file, 2026-09-29]
docs/cam_hanger/iAqua_CamHanger-CamHanger_Upper.stl
22.0 x 18.0 x 100.0
