Brigchen/iAquaria/docs/feeder/stl/Chute.stl

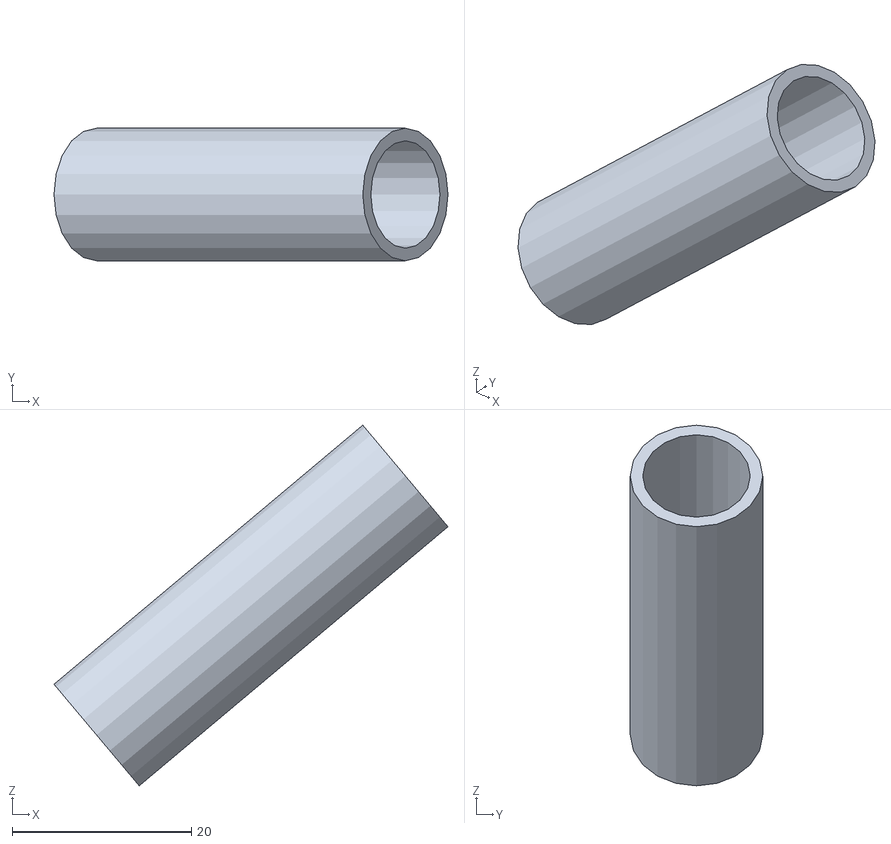
[picture p125: CAD file, 2026-09-29]
docs/feeder/stl/Chute.stl
44.0 x 14.8 x 40.3
