Brigchen/iAquaria/docs/sensor_mounts/stl/Bulkhead_Outer.stl

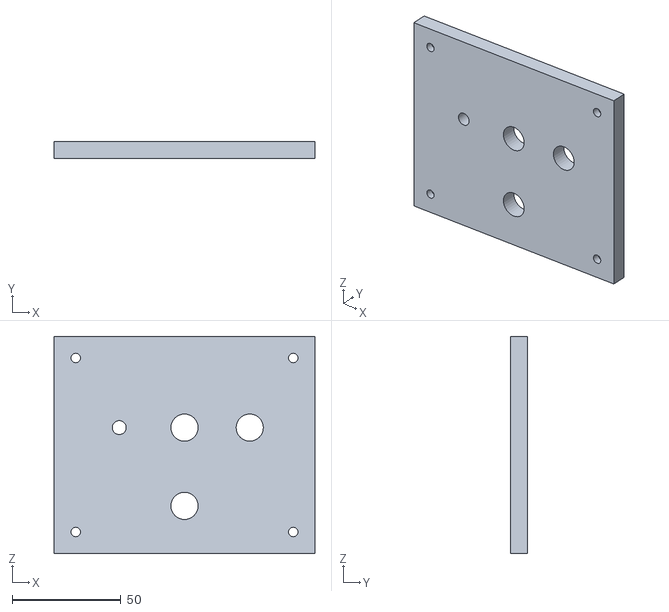
[picture p126: CAD file, 2026-09-29]
docs/sensor_mounts/stl/Bulkhead_Outer.stl
120.0 x 8.00 x 100.0
