Brigchen/iAquaria/docs/usb_cam_case/stl/CamCase_Barrel18.stl

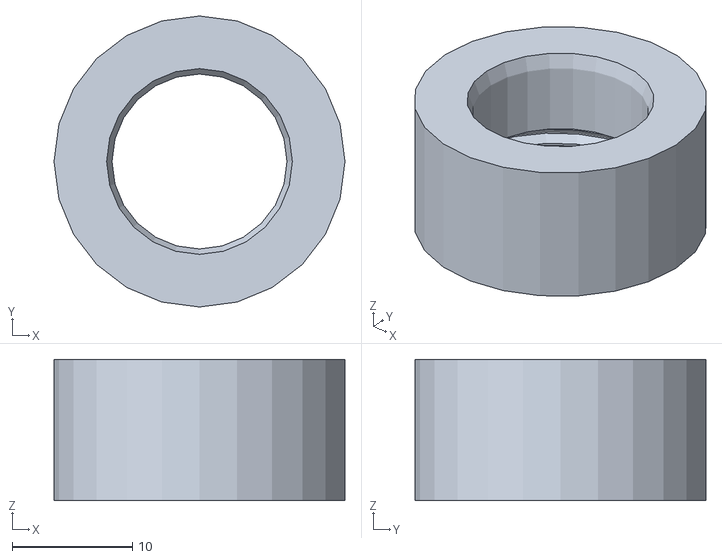
[picture p127: CAD file, 2026-09-29]
docs/usb_cam_case/stl/CamCase_Barrel18.stl
24.2 x 24.2 x 11.7
