Brigchen/iAquaria/docs/cam_hanger/Backplate.stl

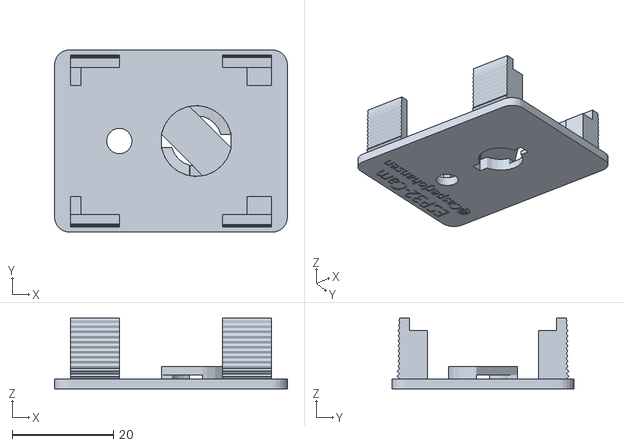
[picture p128: CAD file, 2026-09-29]
docs/cam_hanger/Backplate.stl
46.0 x 36.0 x 14.0
