Brigchen/iAquaria/docs/feeder/stl/Hopper.stl

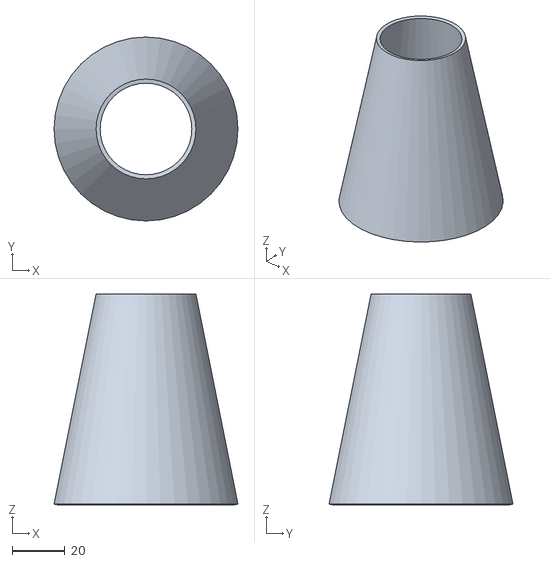
[picture p129: CAD file, 2026-09-29]
docs/feeder/stl/Hopper.stl
70.0 x 70.0 x 80.3
