Brigchen/iAquaria/docs/sensor_mounts/stl/Mount_SR04.stl

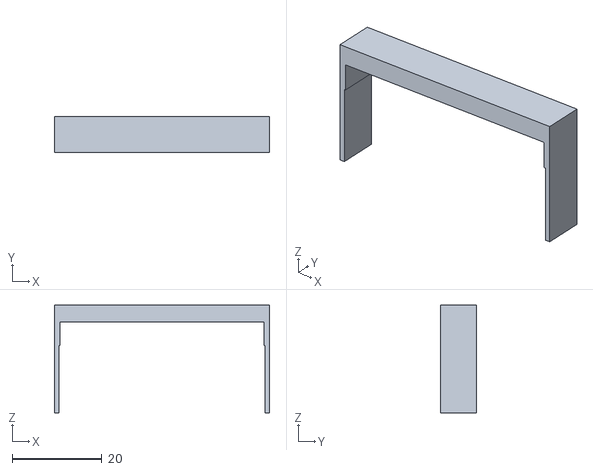
[picture p130: CAD file, 2026-09-29]
docs/sensor_mounts/stl/Mount_SR04.stl
48.0 x 8.00 x 24.0
