Brigchen/iAquaria/docs/usb_cam_case/stl/外壳底盒.stl

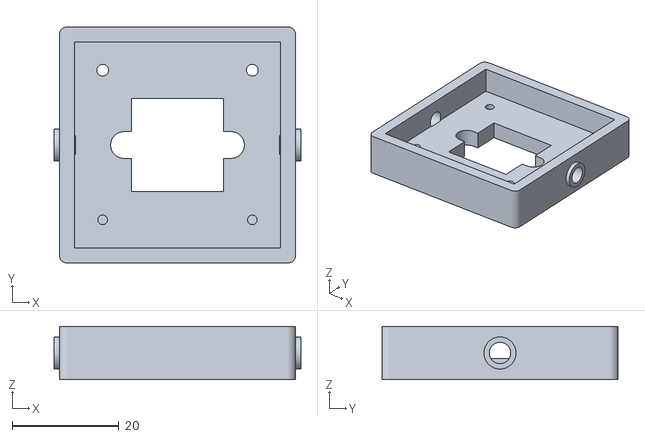
[picture p131: CAD file, 2026-09-29]
docs/usb_cam_case/stl/外壳底盒.stl
46.2 x 44.2 x 10.0
