Brigchen/iAquaria/docs/cam_hanger/iAqua_CamHanger-CamHanger_Lower.stl

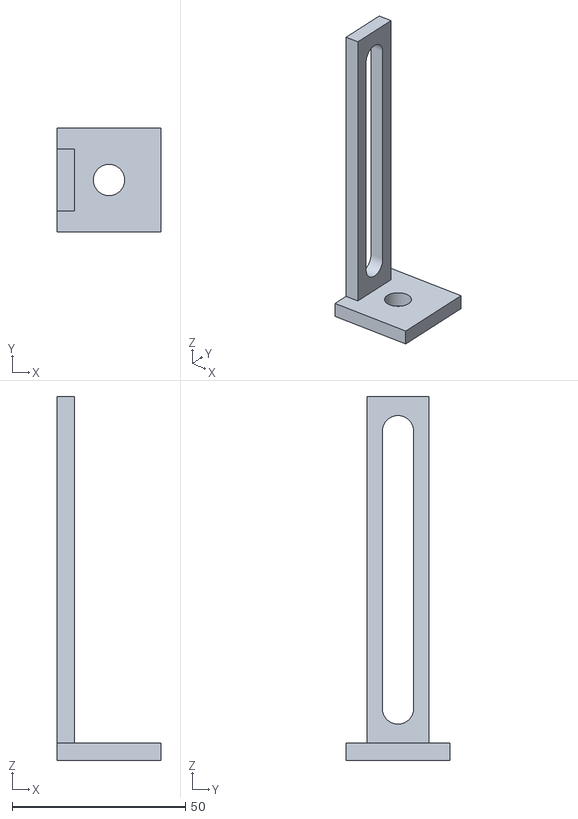
[picture p132: CAD file, 2026-09-29]
docs/cam_hanger/iAqua_CamHanger-CamHanger_Lower.stl
30.0 x 30.0 x 105.0
