Brigchen/iAquaria/docs/feeder/stl/Coupler.stl

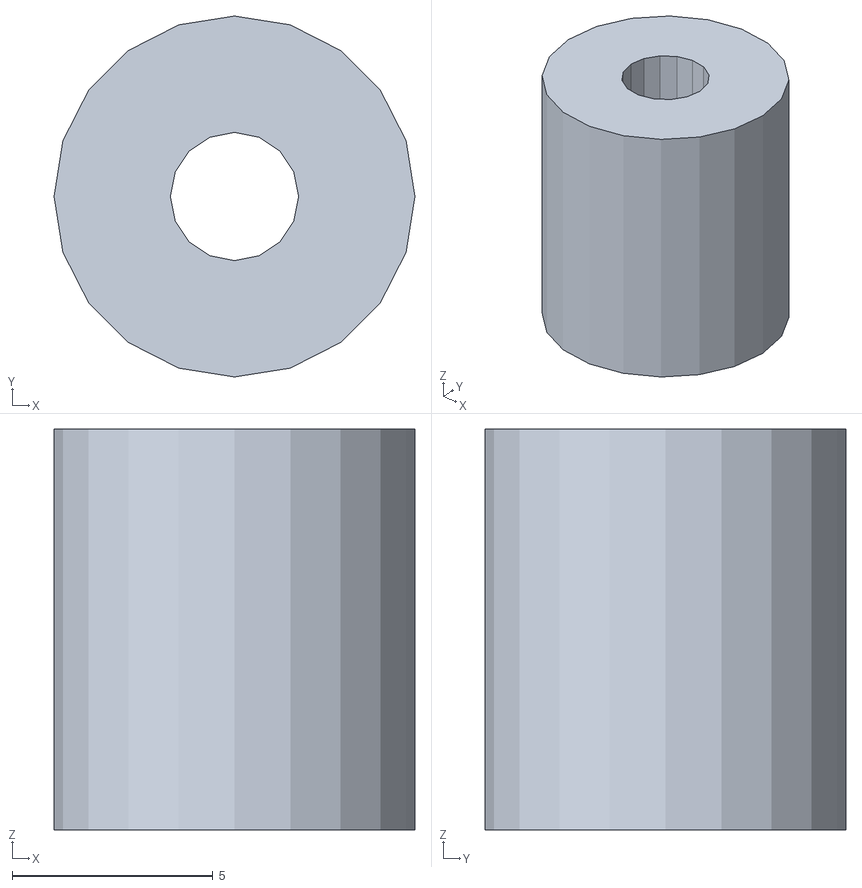
[picture p133: CAD file, 2026-09-29]
docs/feeder/stl/Coupler.stl
9.00 x 9.00 x 10.0
