Brigchen/iAquaria/docs/sensor_mounts/stl/RimClip_Base.stl

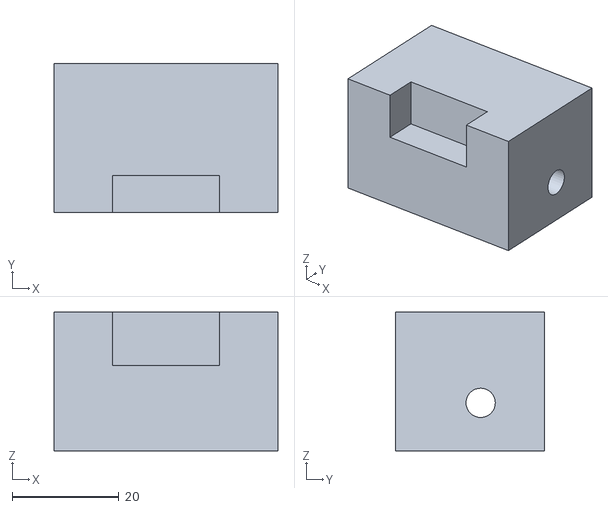
[picture p134: CAD file, 2026-09-29]
docs/sensor_mounts/stl/RimClip_Base.stl
42.0 x 28.0 x 26.0
