Brigchen/iAquaria/docs/cam_hanger/iAqua_CamHanger-Case Antenna Led.stl

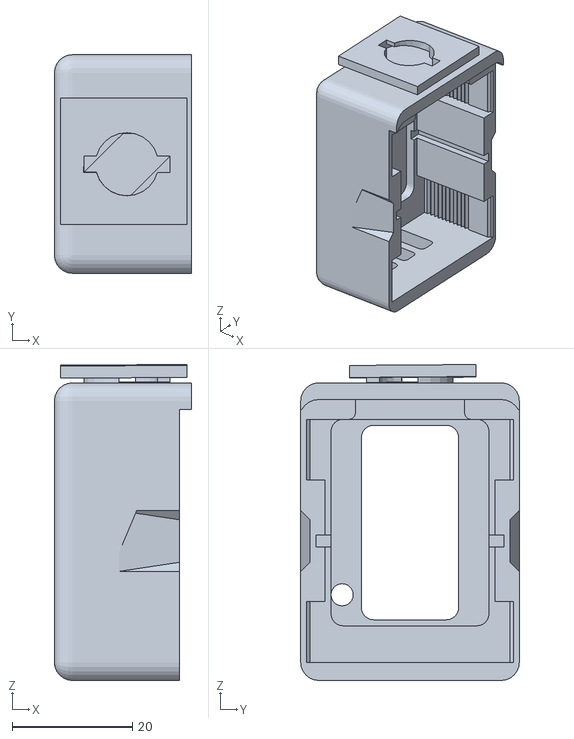
[picture p135: CAD file, 2026-09-29]
docs/cam_hanger/iAqua_CamHanger-Case Antenna Led.stl
22.8 x 36.4 x 52.5
