Brigchen/iAquaria/docs/sensor_mounts/stl/DrillGuide.stl

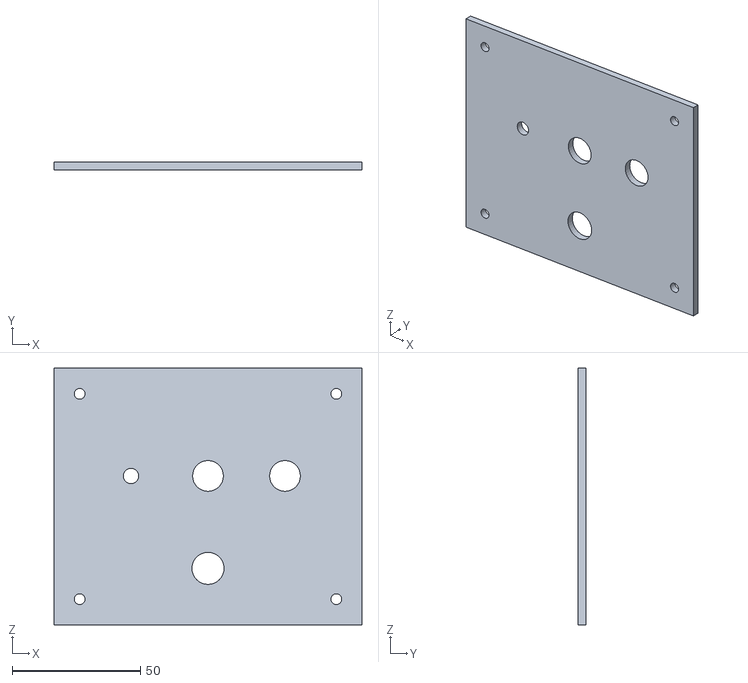
[picture p136: CAD file, 2026-09-29]
docs/sensor_mounts/stl/DrillGuide.stl
120.0 x 3.00 x 100.0
