Brigchen/iAquaria/docs/sensor_mounts/stl/VerticalRail.stl

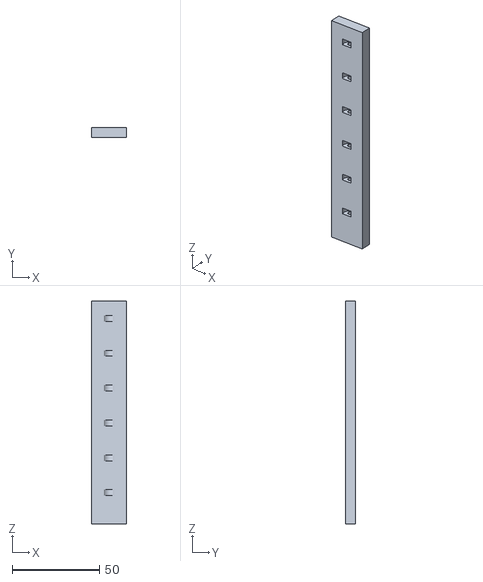
[picture p137: CAD file, 2026-09-29]
docs/sensor_mounts/stl/VerticalRail.stl
20.0 x 6.00 x 128.0
