Brigchen/iAquaria/docs/sensor_mounts/stl/Bulkhead_4Port_Outer.stl

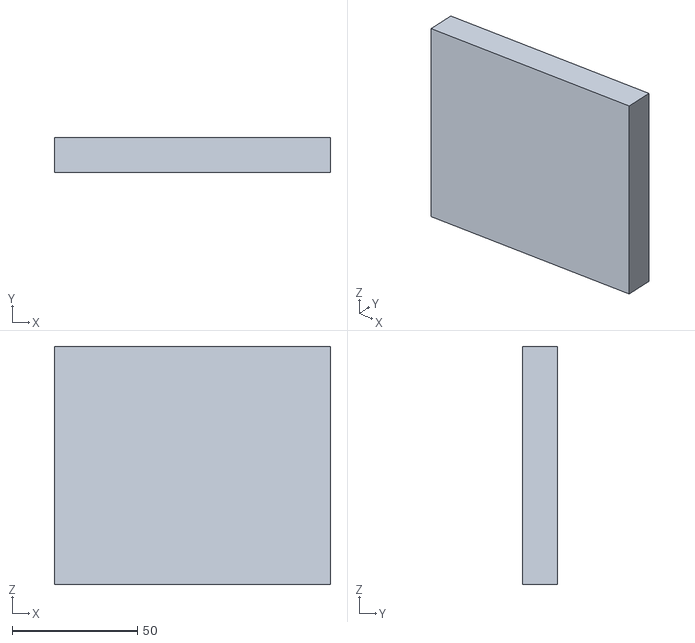
[picture p138: CAD file, 2026-09-29]
docs/sensor_mounts/stl/Bulkhead_4Port_Outer.stl
110.0 x 14.0 x 95.0
