Brigchen/iAquaria/docs/sensor_mounts/stl/Bulkhead_Inner.stl

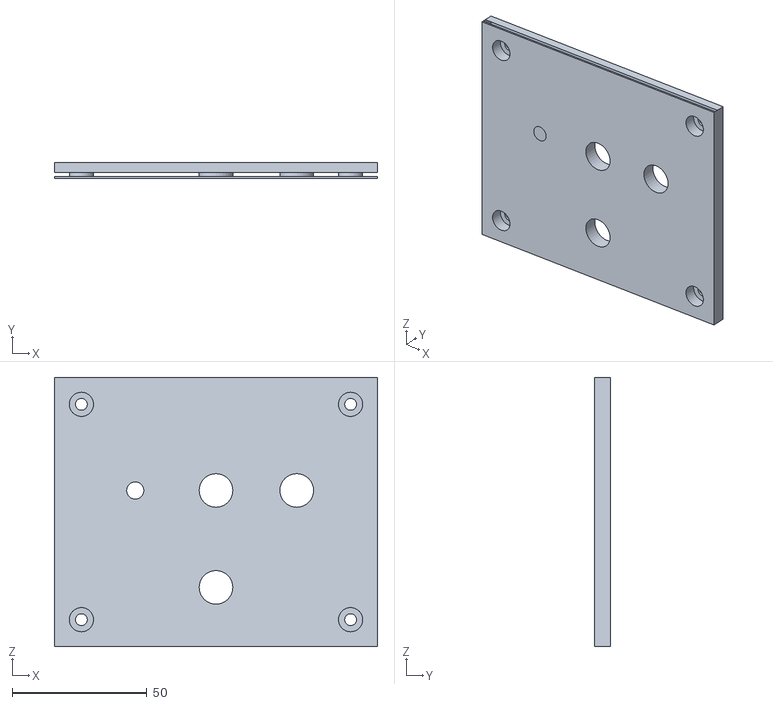
[picture p139: CAD file, 2026-09-29]
docs/sensor_mounts/stl/Bulkhead_Inner.stl
120.0 x 6.00 x 100.0
