Brigchen/iAquaria/docs/sensor_mounts/stl/Gland_Ring_6mm.stl

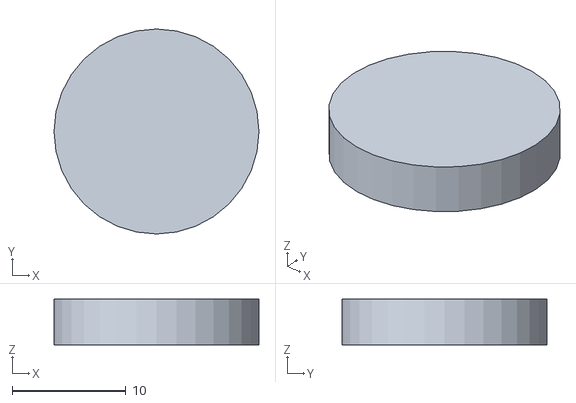
[picture p140: CAD file, 2026-09-29]
docs/sensor_mounts/stl/Gland_Ring_6mm.stl
18.0 x 18.0 x 4.00
