Brigchen/iAquaria/docs/sensor_mounts/stl/Gland_Body_6mm.stl

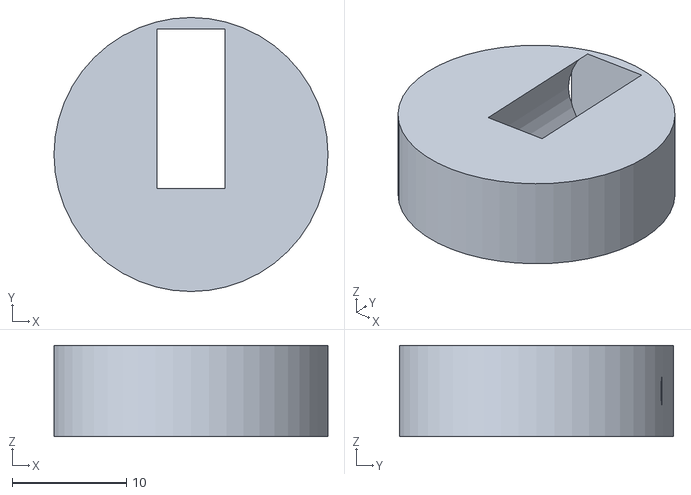
[picture p141: CAD file, 2026-09-29]
docs/sensor_mounts/stl/Gland_Body_6mm.stl
24.0 x 24.0 x 8.00
