Brigchen/iAquaria/(list of files, cad)

Other CAD files:
docs/cam_hanger/stl/Cam_font.stl
docs/cam_hanger/iAqua_CamHanger-CamHanger_M8_1.stl
docs/cam_hanger/iAqua_CamHanger.blend
docs/cam_hanger/stl/iAqua_CamHanger-CamHanger_Upper.stl
docs/feeder/iAqua_Feeder.blend
docs/gy30_case/iAqua_GY30_Case-GY30_Base.stl
docs/gy30_case/iAqua_GY30_Case.blend
docs/ph_KWL_PO_01A_case/pH_KWL_PO_01A_case.blend
docs/probe_h_bracket/iAqua_ProbeH_Bracket.blend
docs/seal_ring/iAqua_SealRing.blend
docs/sensor_mounts/iAqua_SensorMounts.blend
docs/sr04_bracket/iAqua_SR04_Bracket.blend
docs/sr04_bracket/stl/M5x0.8x20.stl
docs/sr04_bracket/stl/M8x1.25x25.stl
docs/tds_h_bracket/iAqua_TdsH_Bracket.blend
docs/usb_cam_case/iAqua_UsbCamCase.blend
