Brigchen/iAquaria/iAqua/test/微信图片_20260914183108_4_65.jpg

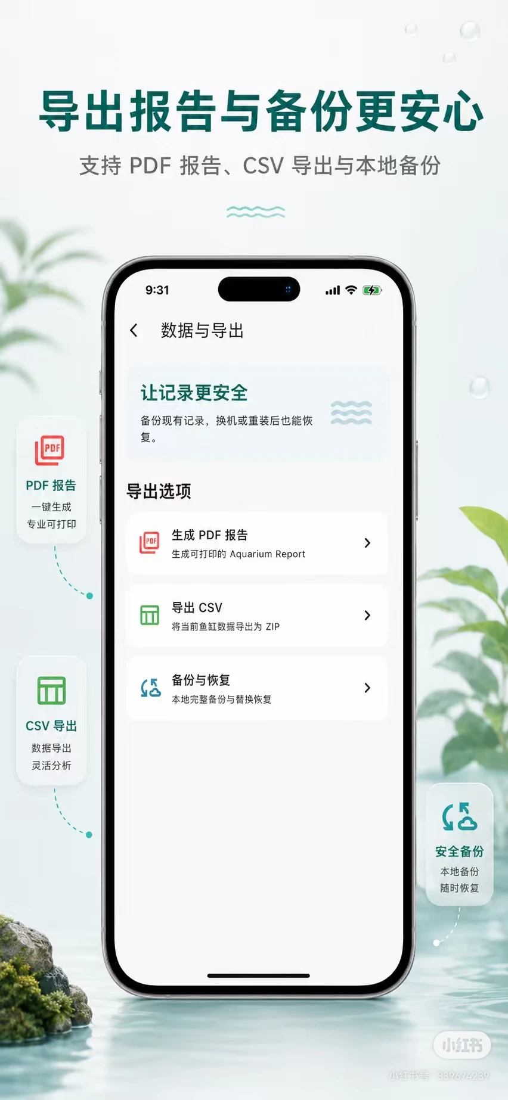
iAqua/test/微信图片_20260914183108_4_65.jpg
