Brigchen/iAquaria/iAqua/test/微信图片_20260914183112_6_65.jpg

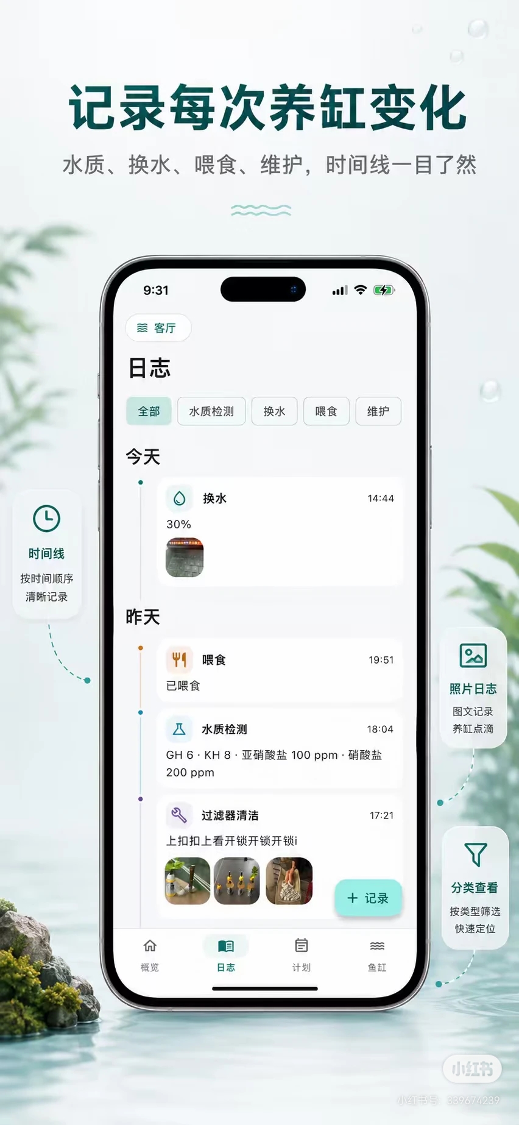
iAqua/test/微信图片_20260914183112_6_65.jpg
