Brigchen/iAquaria/iAquaria/docs/screens/02_日志.jpeg

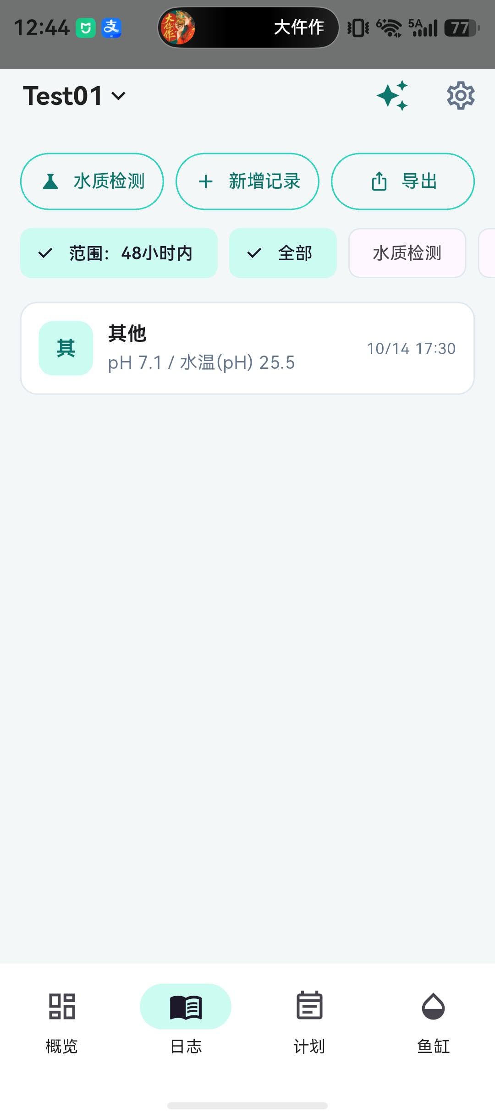
iAquaria/docs/screens/02_日志.jpeg
