Brigchen/iAquaria/(commit log)

2026-09-29 Initial commit of iAqua smart-aquarium monorepo (firmware, cam, host, apps, docs).
    Includes unique mDNS hostnames, TF/SD support, and wiring notes; WiFi credentials in cam/platformio.ini are placeholders.
    [Backplate.stl, Bulkhead_4Port_Inner.stl, Bulkhead_4Port_Outer.stl, Bulkhead_Inner.stl, Bulkhead_Outer.stl, CamCase_Arca.stl, CamCase_Back.stl, CamCase_Barrel14.stl]
2026-10-14 chore(fw/host): 统一 iAquaria 品牌名并更新 485 引脚注释
    - cam/host/主控 Web 界面 iAqua -> iAquaria
    - Config.h 更新 RS485 交叉接线与无 DE/RE 板型说明
    - www_gz.h 重新生成；.gitignore 增补本地临时文件排除
2026-10-14 feat(app): v0.1.0-b21 云端 MQTT、同步、AI、CSV 导出与中文化
    - 云链路：mqtt_cloud_service 只读订阅远程遥测，设置页/鱼缸页配置引导
    - 数据：local_data_service 本地落盘与抽稀、sync_service 云同步、demo 演示数据
    - AI：兼容 OpenAI 协议的多模型分析与水质判断对话
    - 日志：人工水质检测表单与两类 CSV 导出（事件流/宽表，UTF-8 BOM）
    - Temp_pH 卡面与表单中文化为「水温(pH)」，版本号 b21
    - 鸿蒙 module/string 配置更新；补充生物概览测试与真机截图素材
    - 注释/提示中的真实云设备 ID 脱敏为 iaqua-xxxx
2026-10-14 docs: App 使用手册 V1.0-V1.3、参赛设计报告与硬件资料
    - App 使用手册 V1.3（云端 EMQX 开通/欠费停用、数据导出与 pandas 分析、水温(pH) 改名）
    - 参赛队智能水族设计赛道报告 PDF、最新版 BOM/物料清单
    - ESP32 硬件系统安装手册 V1.2、pH 探头外壳 STL/Blender 模型
    - 设计报告插图与传感器曲线图、审核意见报告
    [electro box2_1.stl, electro_box_IP65.stl, iAquaria-最小系统BOM.xlsx, iAquaria-样机物料清单.xlsx, pH_KWL_PO_01A_case-electro box2_1.stl, pH_KWL_PO_01A_case-electro_box_IP65.stl, pH_KWL_PO_01A_case.blend, 订单数据-淘宝.xlsx]
